89Mods/con-badges/EF-Badge-2024/ImageConverters/README.md

Requires stb_image.c/.h, which can be gotten from here: [https://github.com/nothings/stb](https://github.com/nothings/stb)
