89Mods/con-badges/EF-Badge-2025/HW/HW.kicad_pcb

## KiCad design EF-Badge-2025/HW/HW.kicad_pcb (2025-09-15)

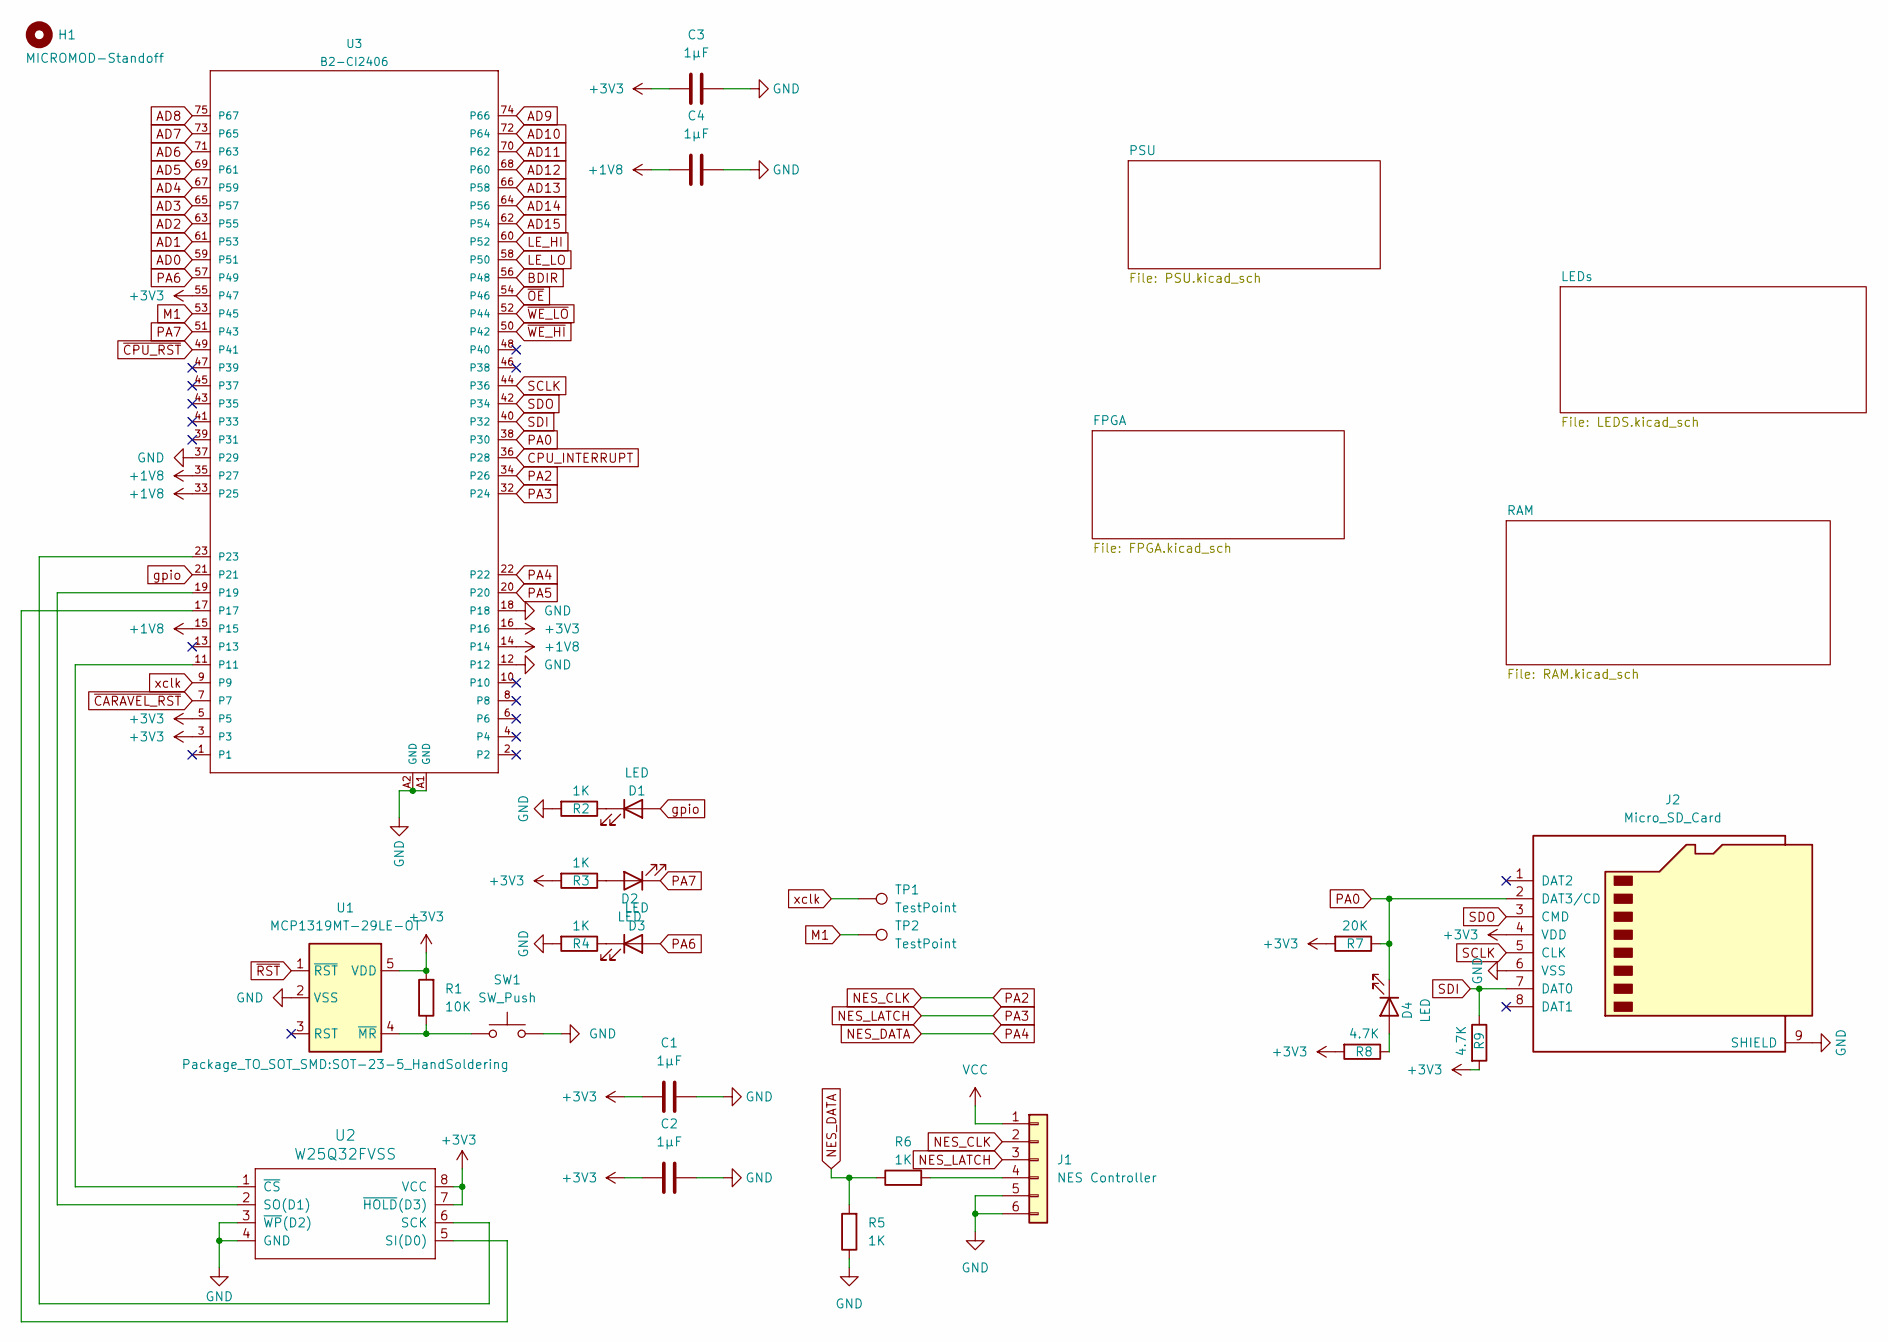
[picture p1: schematic HW.kicad_sch]

Parts:
C1, C2, C3, C4: 1µF; C_0805_2012Metric_Pad1.18x1.45mm_HandSolder
D1, D2, D3, D4: LED; LED_1206_3216Metric_Pad1.42x1.75mm_HandSolder
H1: MICROMOD-Standoff; MicroMod-Standoff
J1: NES Controller; PinSocket_1x06_P2.54mm_Vertical
J2: Micro_SD_Card; microSD_HC_Hirose_DM3AT-SF-PEJM5
R1: 10K; R_1206_3216Metric_Pad1.30x1.75mm_HandSolder
R2, R3, R4, R5, R6: 1K; R_1206_3216Metric_Pad1.30x1.75mm_HandSolder
R7: 20K; R_1206_3216Metric_Pad1.30x1.75mm_HandSolder
R8, R9: 4.7K; R_1206_3216Metric_Pad1.30x1.75mm_HandSolder
SW1: SW_Push; SW_PUSH_6mm
TP1, TP2: TestPoint; TestPoint_Pad_D1.0mm
U1: MCP1319MT-29LE-OT; SOT-23-5_HandSoldering
U2: W25Q32FVSS; DIP-8_W7.62mm; Part # W25Q32JVSSIQ
U3: B2-CI2406; M.2-CONNECTOR-E

Connections:
+1V8: C4.1, U3.14, U3.15, U3.33 (P25), U3.35 (P27); also elsewhere on the board
+3V3: C1.1, C2.1, C3.1, J2.4 (VDD), R1.2, R3.2, R7.2, R8.2, R9.2, U1.5 (VDD), U2.7 (~HOLD(D3)), U2.8 (VCC), U3.3, U3.5, U3.16, U3.55 (P47); also elsewhere on the board
AD0: U3.59 (P51); also elsewhere on the board
AD1: U3.61 (P53); also elsewhere on the board
AD2: U3.63 (P55); also elsewhere on the board
AD3: U3.65 (P57); also elsewhere on the board
AD4: U3.67 (P59); also elsewhere on the board
AD5: U3.69 (P61); also elsewhere on the board
AD6: U3.71 (P63); also elsewhere on the board
AD7: U3.73 (P65); also elsewhere on the board
AD8: U3.75 (P67); also elsewhere on the board
AD9: U3.74 (P66); also elsewhere on the board
AD10: U3.72 (P64); also elsewhere on the board
AD11: U3.70 (P62); also elsewhere on the board
AD12: U3.68 (P60); also elsewhere on the board
AD13: U3.66 (P58); also elsewhere on the board
AD14: U3.64 (P56); also elsewhere on the board
AD15: U3.62 (P54); also elsewhere on the board
BDIR: U3.56 (P48)
CPU_INTERRUPT: U3.36 (P28); also elsewhere on the board
GND: C1.2, C2.2, C3.2, C4.2, J1.5, J1.6, J2.6 (VSS), J2.9 (SHIELD), R2.2, R4.2, R5.1, SW1.2, U1.2 (VSS), U2.3 (~WP(D2)), U2.4 (GND), U3.12, U3.18, U3.37 (P29), U3.A1 (GND), U3.A2 (GND); also elsewhere on the board
LE_HI: U3.60 (P52); also elsewhere on the board
LE_LO: U3.58 (P50); also elsewhere on the board
M1: TP2.1, U3.53 (P45)
NES_CLK: J1.2, U3.34 (P26)
NES_DATA: R5.2, R6.1, U3.22
NES_LATCH: J1.3, U3.32 (P24)
unnamed: D1.1 (K), R2.1
unnamed: D2.2 (A), R3.1
unnamed: D3.1 (K), R4.1
unnamed: D4.2 (A), R8.1
unnamed: J1.4, R6.2
unnamed: R1.1, SW1.1, U1.4 (~MR)
unnamed: U2.6 (SCK), U3.23
unnamed: U2.5 (SI(D0)), U3.17
unnamed: U2.2 (SO(D1)), U3.19
unnamed: U2.1 (~CS), U3.11
PA0: D4.1 (K), J2.2 (DAT3/CD), R7.1, U3.38 (P30)
PA5: U3.20
PA6: D3.2 (A), U3.57 (P49)
PA7: D2.1 (K), U3.51 (P43)
SCLK: J2.5 (CLK), U3.44 (P36)
SDI: J2.7 (DAT0), R9.1, U3.40 (P32)
SDO: J2.3 (CMD), U3.42 (P34)
VCC: J1.1; also elsewhere on the board
gpio: D1.2 (A), U3.21; also elsewhere on the board
xclk: TP1.1, U3.9; also elsewhere on the board
~CARAVEL_RST: U3.7; also elsewhere on the board
~CPU_RST: U3.49 (P41); also elsewhere on the board
~OE: U3.54 (P46); also elsewhere on the board
~RST: U1.1 (~RST); also elsewhere on the board
~WE_HI: U3.50 (P42); also elsewhere on the board
~WE_LO: U3.52 (P44); also elsewhere on the board

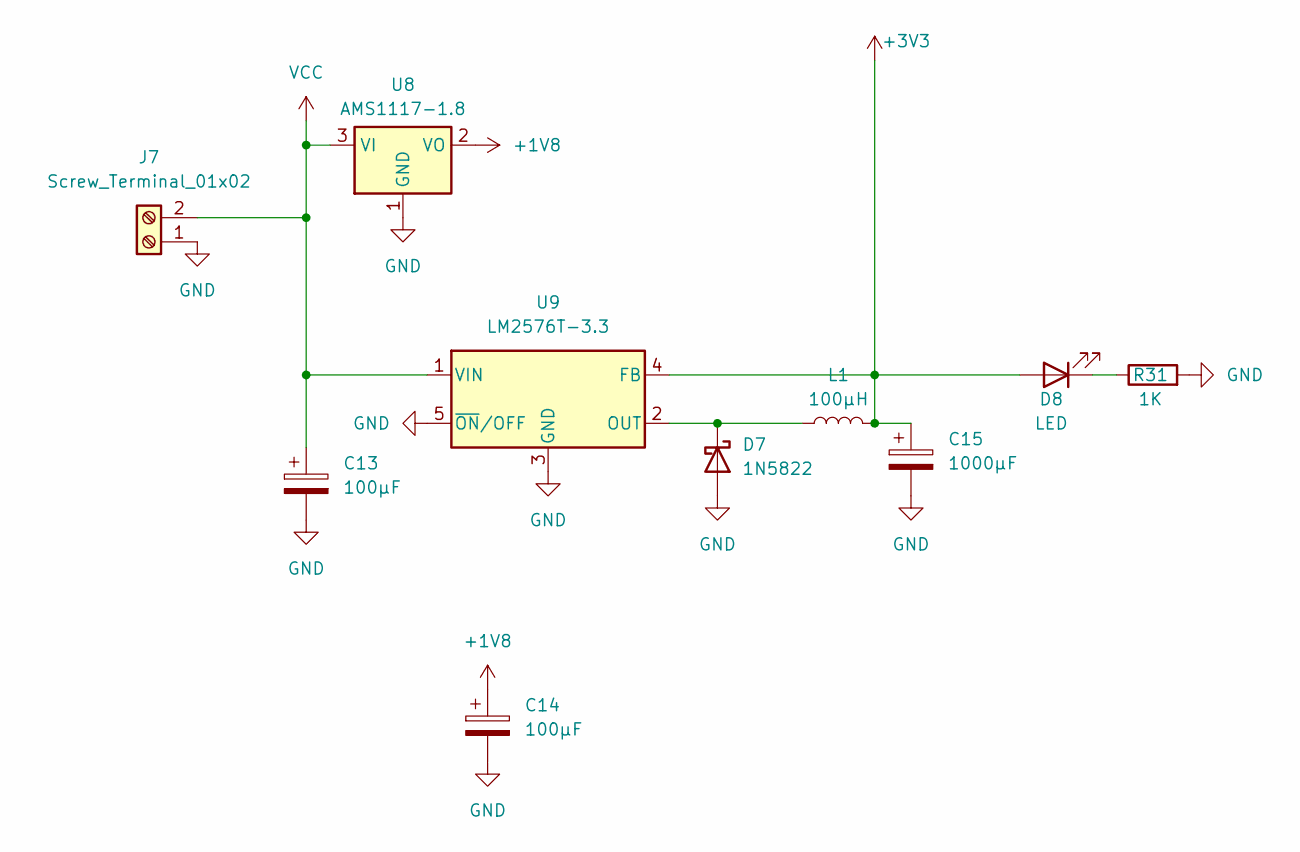
[picture p2: schematic PSU.kicad_sch]

Parts:
C13: 100µF; CP_Radial_D5.0mm_P2.50mm
C14: 100µF; CP_Elec_4x3
C15: 1000µF; CP_Radial_D6.3mm_P2.50mm
D7: 1N5822; D_DO-201AD_P15.24mm_Horizontal
D8: LED; LED_1206_3216Metric_Pad1.42x1.75mm_HandSolder
J7: Screw_Terminal_01x02; TerminalBlock_bornier-2_P5.08mm
L1: 100µH; L_Radial_D6.0mm_P4.00mm
R31: 1K; R_1206_3216Metric_Pad1.30x1.75mm_HandSolder
U8: AMS1117-1.8; SOT-223-3_TabPin2
U9: LM2576T-3.3; TO-220-5_Horizontal_TabDown_Fixed

Connections:
+1V8: C14.1, U8.2 (VO); also elsewhere on the board
+3V3: C15.1, D8.2 (A), L1.2, U9.4 (FB); also elsewhere on the board
GND: C13.2, C14.2, C15.2, D7.2 (A), J7.1, R31.2, U8.1 (GND), U9.3 (GND), U9.5 (~ON/OFF); also elsewhere on the board
unnamed: D7.1 (K), L1.1, U9.2 (OUT)
unnamed: D8.1 (K), R31.1
VCC: C13.1, J7.2, U8.3 (VI), U9.1 (VIN); also elsewhere on the board

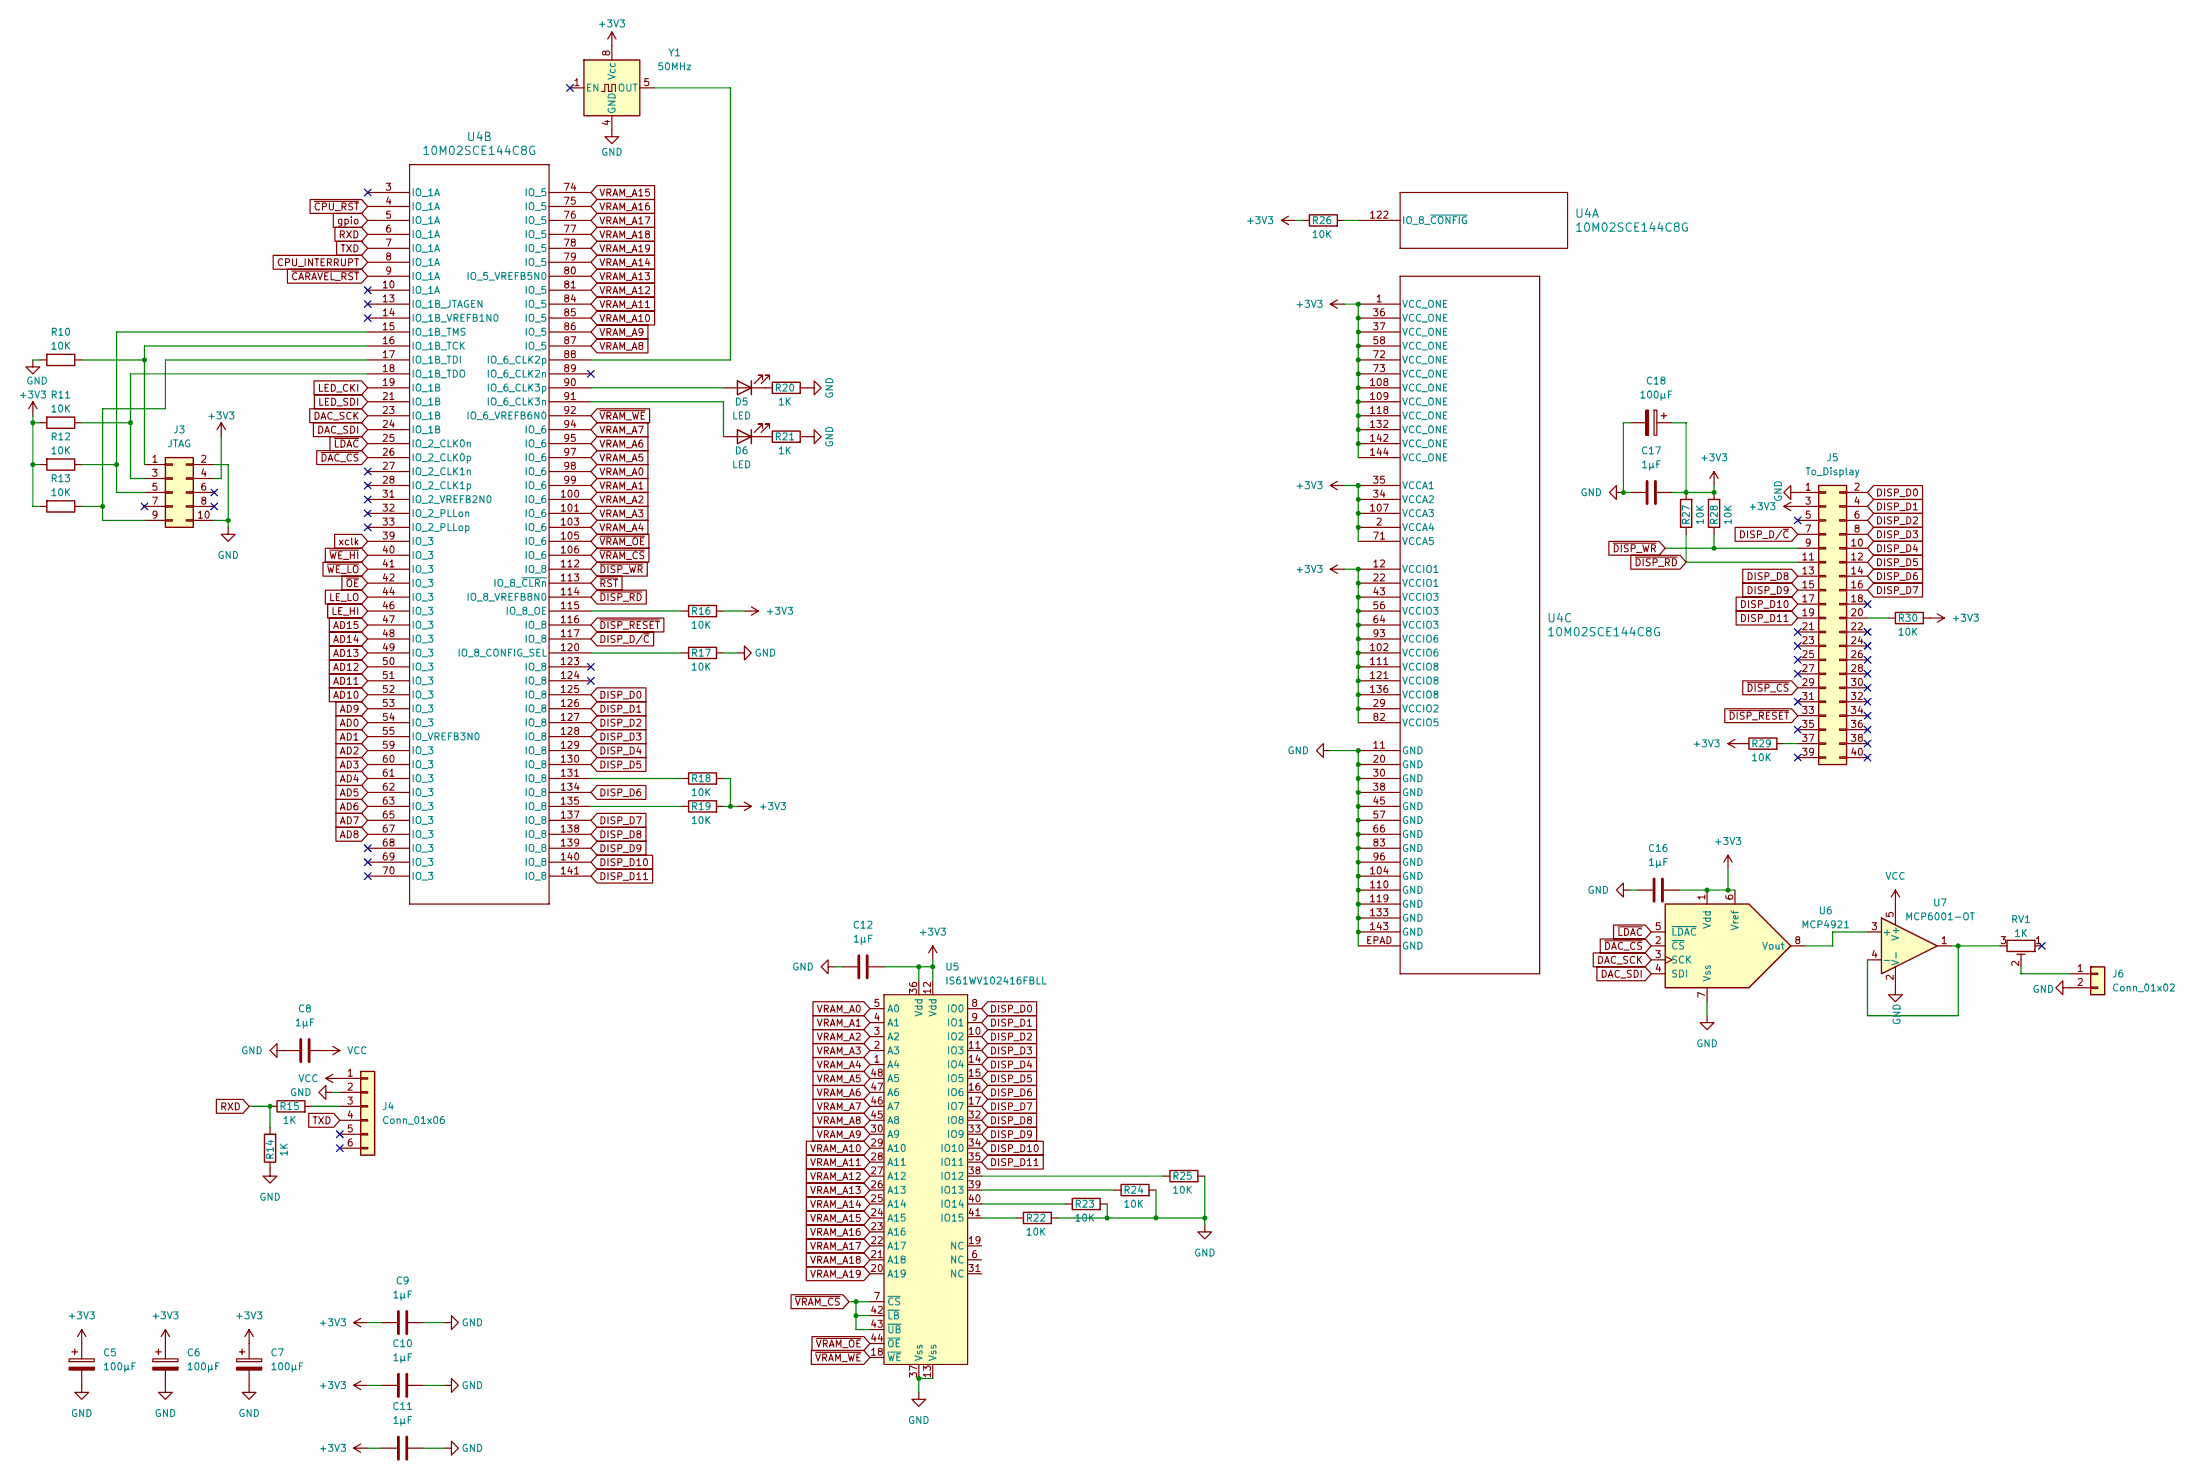
[picture p3: schematic FPGA.kicad_sch]

Parts:
C5, C6, C7, C18: 100µF; CP_Elec_4x3
C8, C9, C10, C11, C12, C16, C17: 1µF; C_0805_2012Metric_Pad1.18x1.45mm_HandSolder
D5, D6: LED; LED_1206_3216Metric_Pad1.42x1.75mm_HandSolder
J3: JTAG; PinHeader_2x05_P2.54mm_Vertical
J4: Conn_01x06; PinSocket_1x06_P2.54mm_Vertical
J5: To_Display; PinHeader_2x20_P2.54mm_Vertical
J6: Conn_01x02; PinHeader_1x02_P2.54mm_Vertical
R10, R11, R12, R13, R16, R17, R18, R19, R22, R23, R24, R25, R26, R27, R28, R29, R30: 10K; R_1206_3216Metric_Pad1.30x1.75mm_HandSolder
R14, R15, R20, R21: 1K; R_1206_3216Metric_Pad1.30x1.75mm_HandSolder
RV1: 1K; Potentiometer_ACP_CA9-V10_Vertical
U4: 10M02SCE144C8G; EQFP144_A-1.65-D2-4.0_INT
U5: IS61WV102416FBLL; TSOP-I-48_18.4x12mm_P0.5mm; Mouser 870-61WV12416FBL1TLI
U6: MCP4921; DIP-8_W7.62mm
U7: MCP6001-OT; SOT-23-5
Y1: 50MHz; Oscillator_DIP-8

Connections:
+3V3: C5.1, C6.1, C7.1, C9.1, C10.1, C11.1, C12.2, C16.2, C17.2, C18.1, J3.4, J5.3, R11.2, R12.2, R13.2, R16.2, R18.2, R19.2, R26.1, R27.2, R28.2, R29.1, R30.2, U4.1 (VCC_ONE), U4.2 (VCCA4), U4.12 (VCCIO1), U4.22 (VCCIO1), U4.29 (VCCIO2), U4.34 (VCCA2), U4.35 (VCCA1), U4.36 (VCC_ONE), U4.37 (VCC_ONE), U4.43 (VCCIO3), U4.56 (VCCIO3), U4.58 (VCC_ONE), U4.64 (VCCIO3), U4.71 (VCCA5), U4.72 (VCC_ONE), U4.73 (VCC_ONE), U4.82 (VCCIO5), U4.93 (VCCIO6), U4.102 (VCCIO6), U4.107 (VCCA3), U4.108 (VCC_ONE), U4.109 (VCC_ONE), U4.111 (VCCIO8), U4.118 (VCC_ONE), U4.121 (VCCIO8), U4.132 (VCC_ONE), U4.136 (VCCIO8), U4.142 (VCC_ONE), U4.144 (VCC_ONE), U5.12 (Vdd), U5.36 (Vdd), U6.1 (Vdd), U6.6 (Vref), Y1.8 (Vcc); also elsewhere on the board
AD0: U4.54 (IO_3); also elsewhere on the board
AD1: U4.55 (IO_VREFB3N0); also elsewhere on the board
AD2: U4.59 (IO_3); also elsewhere on the board
AD3: U4.60 (IO_3); also elsewhere on the board
AD4: U4.61 (IO_3); also elsewhere on the board
AD5: U4.62 (IO_3); also elsewhere on the board
AD6: U4.63 (IO_3); also elsewhere on the board
AD7: U4.65 (IO_3); also elsewhere on the board
AD8: U4.67 (IO_3); also elsewhere on the board
AD9: U4.53 (IO_3); also elsewhere on the board
AD10: U4.52 (IO_3); also elsewhere on the board
AD11: U4.51 (IO_3); also elsewhere on the board
AD12: U4.50 (IO_3); also elsewhere on the board
AD13: U4.49 (IO_3); also elsewhere on the board
AD14: U4.48 (IO_3); also elsewhere on the board
AD15: U4.47 (IO_3); also elsewhere on the board
CPU_INTERRUPT: U4.8 (IO_1A); also elsewhere on the board
DAC_SCK: U4.23 (IO_1B), U6.3 (SCK)
DAC_SDI: U4.24 (IO_1B), U6.4 (SDI)
DISP_D0: J5.2, U4.125 (IO_8), U5.8 (IO0)
DISP_D1: J5.4, U4.126 (IO_8), U5.9 (IO1)
DISP_D2: J5.6, U4.127 (IO_8), U5.10 (IO2)
DISP_D3: J5.8, U4.128 (IO_8), U5.11 (IO3)
DISP_D4: J5.10, U4.129 (IO_8), U5.14 (IO4)
DISP_D5: J5.12, U4.130 (IO_8), U5.15 (IO5)
DISP_D6: J5.14, U4.134 (IO_8), U5.16 (IO6)
DISP_D7: J5.16, U4.137 (IO_8), U5.17 (IO7)
DISP_D8: J5.13, U4.138 (IO_8), U5.32 (IO8)
DISP_D9: J5.15, U4.139 (IO_8), U5.33 (IO9)
DISP_D10: J5.17, U4.140 (IO_8), U5.34 (IO10)
DISP_D11: J5.19, U4.141 (IO_8), U5.35 (IO11)
DISP_D/~C: J5.7, U4.117 (IO_8)
GND: C5.2, C6.2, C7.2, C8.1, C9.2, C10.2, C11.2, C12.1, C16.1, C17.1, C18.2, J3.2, J3.10, J4.2, J5.1, J6.2, R10.2, R14.1, R17.2, R20.2, R21.2, R22.2, R23.2, R24.2, R25.2, U4.11 (GND), U4.20 (GND), U4.30 (GND), U4.38 (GND), U4.45 (GND), U4.57 (GND), U4.66 (GND), U4.83 (GND), U4.96 (GND), U4.104 (GND), U4.110 (GND), U4.119 (GND), U4.133 (GND), U4.143 (GND), U4.EPAD (GND), U5.13 (Vss), U5.37 (Vss), U6.7 (Vss), U7.2 (V-), Y1.4 (GND); also elsewhere on the board
LED_CKI: U4.19 (IO_1B); also elsewhere on the board
LED_SDI: U4.21 (IO_1B); also elsewhere on the board
LE_HI: U4.46 (IO_3); also elsewhere on the board
LE_LO: U4.44 (IO_3); also elsewhere on the board
unnamed: D5.2 (A), U4.90 (IO_6_CLK3p)
unnamed: D5.1 (K), R20.1
unnamed: D6.2 (A), U4.91 (IO_6_CLK3n)
unnamed: D6.1 (K), R21.1
unnamed: J3.1, R10.1, U4.16 (IO_1B_TCK)
unnamed: J3.3, R11.1, U4.18 (IO_1B_TDO)
unnamed: J3.5, R12.1, U4.15 (IO_1B_TMS)
unnamed: J3.9, R13.1, U4.17 (IO_1B_TDI)
unnamed: J4.3, R15.2
unnamed: J5.20, R30.1
unnamed: J5.37, R29.2
unnamed: J6.1, RV1.2
unnamed: R18.1, U4.131 (IO_8)
unnamed: R19.1, U4.135 (IO_8)
unnamed: R26.2, U4.122 (IO_8_~CONFIG)
unnamed: U4.88 (IO_6_CLK2p), Y1.5 (OUT)
unnamed: R17.1, U4.120 (IO_8_CONFIG_SEL)
unnamed: R16.1, U4.115 (IO_8_OE)
unnamed: R25.1, U5.38 (IO12)
unnamed: R24.1, U5.39 (IO13)
unnamed: R23.1, U5.40 (IO14)
unnamed: R22.1, U5.41 (IO15)
unnamed: U6.8 (Vout), U7.3 (+)
unnamed: RV1.3, U7.1, U7.4 (-)
RXD: R14.2, R15.1, U4.6 (IO_1A)
TXD: J4.4, U4.7 (IO_1A)
VCC: C8.2, J4.1, U7.5 (V+); also elsewhere on the board
VRAM_A0: U4.98 (IO_6), U5.5 (A0)
VRAM_A1: U4.99 (IO_6), U5.4 (A1)
VRAM_A2: U4.100 (IO_6), U5.3 (A2)
VRAM_A3: U4.101 (IO_6), U5.2 (A3)
VRAM_A4: U4.103 (IO_6), U5.1 (A4)
VRAM_A5: U4.97 (IO_6), U5.48 (A5)
VRAM_A6: U4.95 (IO_6), U5.47 (A6)
VRAM_A7: U4.94 (IO_6), U5.46 (A7)
VRAM_A8: U4.87 (IO_5), U5.45 (A8)
VRAM_A9: U4.86 (IO_5), U5.30 (A9)
VRAM_A10: U4.85 (IO_5), U5.29 (A10)
VRAM_A11: U4.84 (IO_5), U5.28 (A11)
VRAM_A12: U4.81 (IO_5), U5.27 (A12)
VRAM_A13: U4.80 (IO_5_VREFB5N0), U5.26 (A13)
VRAM_A14: U4.79 (IO_5), U5.25 (A14)
VRAM_A15: U4.74 (IO_5), U5.24 (A15)
VRAM_A16: U4.75 (IO_5), U5.23 (A16)
VRAM_A17: U4.76 (IO_5), U5.22 (A17)
VRAM_A18: U4.77 (IO_5), U5.21 (A18)
VRAM_A19: U4.78 (IO_5), U5.20 (A19)
gpio: U4.5 (IO_1A); also elsewhere on the board
xclk: U4.39 (IO_3); also elsewhere on the board
~CARAVEL_RST: U4.9 (IO_1A); also elsewhere on the board
~CPU_RST: U4.4 (IO_1A); also elsewhere on the board
~DAC_CS: U4.26 (IO_2_CLK0p), U6.2 (~CS)
~DISP_CS: J5.29
~DISP_RD: J5.11, R27.1, U4.114 (IO_8_VREFB8N0)
~DISP_RESET: J5.33, U4.116 (IO_8)
~DISP_WR: J5.9, R28.1, U4.112 (IO_8)
~LDAC: U4.25 (IO_2_CLK0n), U6.5 (~LDAC)
~OE: U4.42 (IO_3); also elsewhere on the board
~RST: U4.113 (IO_8_~CLRn); also elsewhere on the board
~VRAM_CS: U4.106 (IO_6), U5.7 (~CS), U5.42 (~LB), U5.43 (~UB)
~VRAM_OE: U4.105 (IO_6), U5.44 (~OE)
~VRAM_WE: U4.92 (IO_6_VREFB6N0), U5.18 (~WE)
~WE_HI: U4.40 (IO_3); also elsewhere on the board
~WE_LO: U4.41 (IO_3); also elsewhere on the board

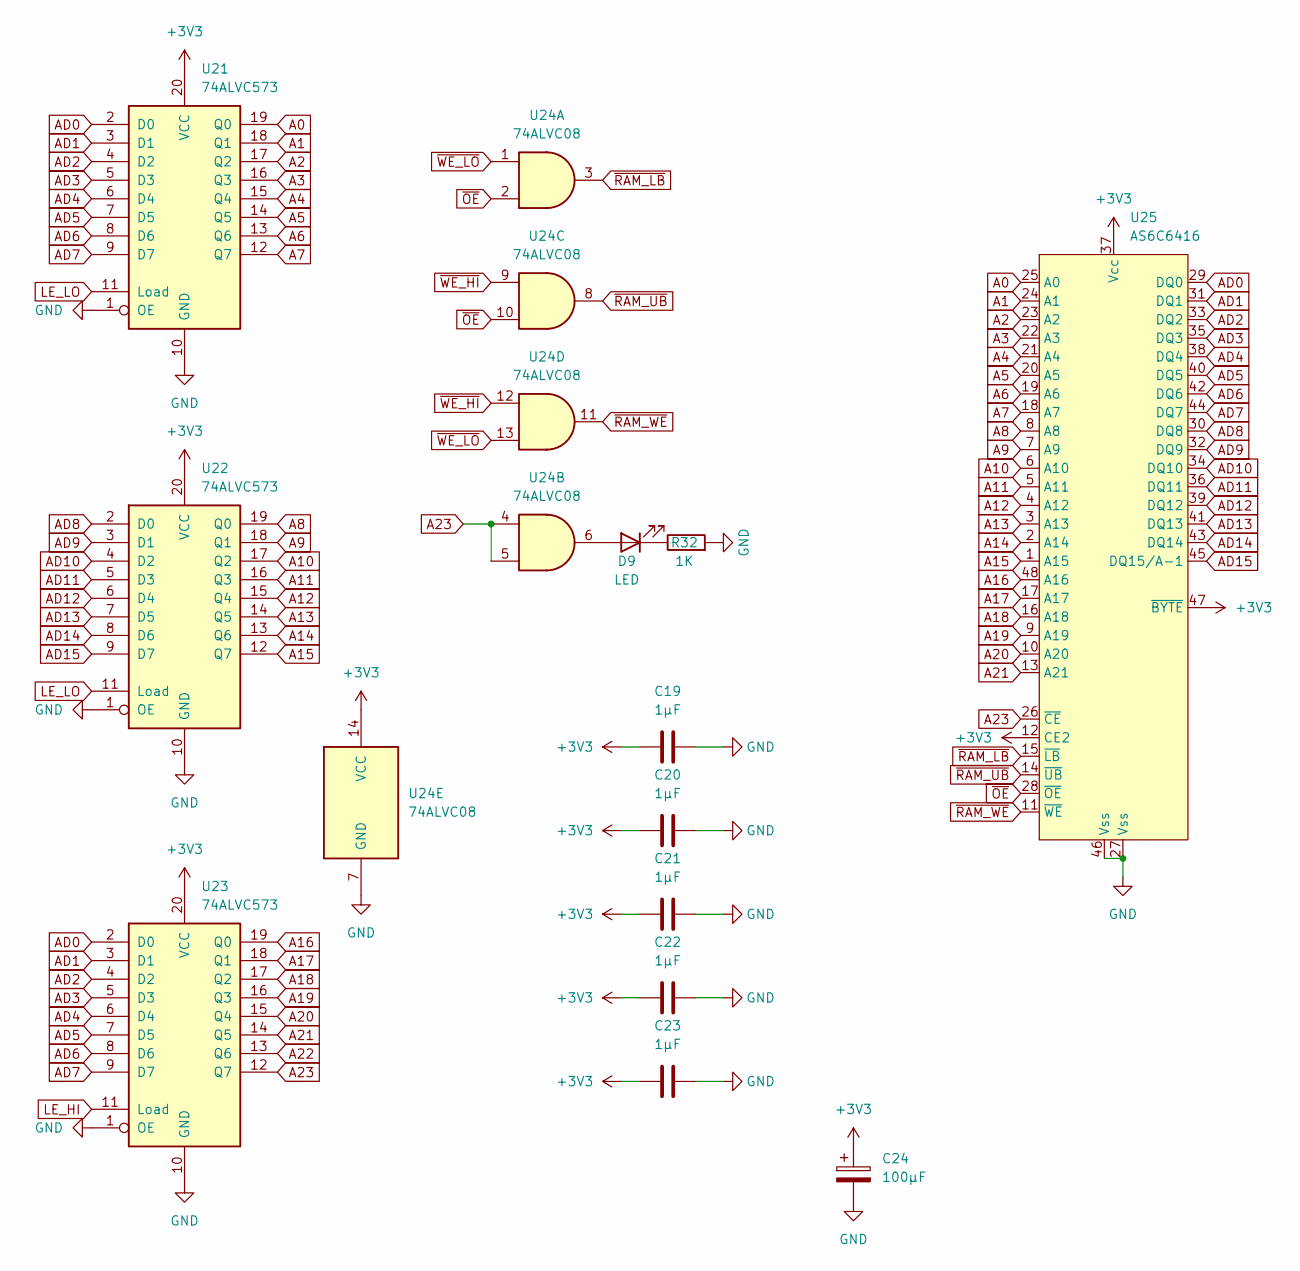
[picture p4: schematic RAM.kicad_sch]

Parts:
C19, C20, C21, C22, C23: 1µF; C_0805_2012Metric_Pad1.18x1.45mm_HandSolder
C24: 100µF; CP_Elec_4x3
D9: LED; LED_1206_3216Metric_Pad1.42x1.75mm_HandSolder
R32: 1K; R_1206_3216Metric_Pad1.30x1.75mm_HandSolder
U21, U22, U23: 74ALVC573; TSSOP-20_4.4x6.5mm_P0.65mm; Mouser 771-ALVC573PW118
U24: 74ALVC08; SOIC-14_3.9x8.7mm_P1.27mm; Mouser 771-ALVC08D118
U25: AS6C6416; TSOP-I-48_18.4x12mm_P0.5mm; Mouser 913-AS6C6416-55TIN

Connections:
+3V3: C19.1, C20.1, C21.1, C22.1, C23.1, C24.1, U21.20 (VCC), U22.20 (VCC), U23.20 (VCC), U24.14 (VCC), U25.12 (CE2), U25.37 (Vcc), U25.47 (~BYTE); also elsewhere on the board
A0: U21.19 (Q0), U25.25 (A0)
A1: U21.18 (Q1), U25.24 (A1)
A2: U21.17 (Q2), U25.23 (A2)
A3: U21.16 (Q3), U25.22 (A3)
A4: U21.15 (Q4), U25.21 (A4)
A5: U21.14 (Q5), U25.20 (A5)
A6: U21.13 (Q6), U25.19 (A6)
A7: U21.12 (Q7), U25.18 (A7)
A8: U22.19 (Q0), U25.8 (A8)
A9: U22.18 (Q1), U25.7 (A9)
A10: U22.17 (Q2), U25.6 (A10)
A11: U22.16 (Q3), U25.5 (A11)
A12: U22.15 (Q4), U25.4 (A12)
A13: U22.14 (Q5), U25.3 (A13)
A14: U22.13 (Q6), U25.2 (A14)
A15: U22.12 (Q7), U25.1 (A15)
A16: U23.19 (Q0), U25.48 (A16)
A17: U23.18 (Q1), U25.17 (A17)
A18: U23.17 (Q2), U25.16 (A18)
A19: U23.16 (Q3), U25.9 (A19)
A20: U23.15 (Q4), U25.10 (A20)
A21: U23.14 (Q5), U25.13 (A21)
A22: U23.13 (Q6)
A23: U23.12 (Q7), U24.4, U24.5, U25.26 (~CE)
AD0: U21.2 (D0), U23.2 (D0), U25.29 (DQ0); also elsewhere on the board
AD1: U21.3 (D1), U23.3 (D1), U25.31 (DQ1); also elsewhere on the board
AD2: U21.4 (D2), U23.4 (D2), U25.33 (DQ2); also elsewhere on the board
AD3: U21.5 (D3), U23.5 (D3), U25.35 (DQ3); also elsewhere on the board
AD4: U21.6 (D4), U23.6 (D4), U25.38 (DQ4); also elsewhere on the board
AD5: U21.7 (D5), U23.7 (D5), U25.40 (DQ5); also elsewhere on the board
AD6: U21.8 (D6), U23.8 (D6), U25.42 (DQ6); also elsewhere on the board
AD7: U21.9 (D7), U23.9 (D7), U25.44 (DQ7); also elsewhere on the board
AD8: U22.2 (D0), U25.30 (DQ8); also elsewhere on the board
AD9: U22.3 (D1), U25.32 (DQ9); also elsewhere on the board
AD10: U22.4 (D2), U25.34 (DQ10); also elsewhere on the board
AD11: U22.5 (D3), U25.36 (DQ11); also elsewhere on the board
AD12: U22.6 (D4), U25.39 (DQ12); also elsewhere on the board
AD13: U22.7 (D5), U25.41 (DQ13); also elsewhere on the board
AD14: U22.8 (D6), U25.43 (DQ14); also elsewhere on the board
AD15: U22.9 (D7), U25.45 (DQ15/A-1); also elsewhere on the board
GND: C19.2, C20.2, C21.2, C22.2, C23.2, C24.2, R32.2, U21.1 (OE), U21.10 (GND), U22.1 (OE), U22.10 (GND), U23.1 (OE), U23.10 (GND), U24.7 (GND), U25.27 (Vss), U25.46 (Vss); also elsewhere on the board
LE_HI: U23.11 (Load); also elsewhere on the board
LE_LO: U21.11 (Load), U22.11 (Load); also elsewhere on the board
unnamed: D9.2 (A), U24.6
unnamed: D9.1 (K), R32.1
~OE: U24.2, U24.10, U25.28 (~OE); also elsewhere on the board
~RAM_LB: U24.3, U25.15 (~LB)
~RAM_UB: U24.8, U25.14 (~UB)
~RAM_WE: U24.11, U25.11 (~WE)
~WE_HI: U24.9, U24.12; also elsewhere on the board
~WE_LO: U24.1, U24.13; also elsewhere on the board

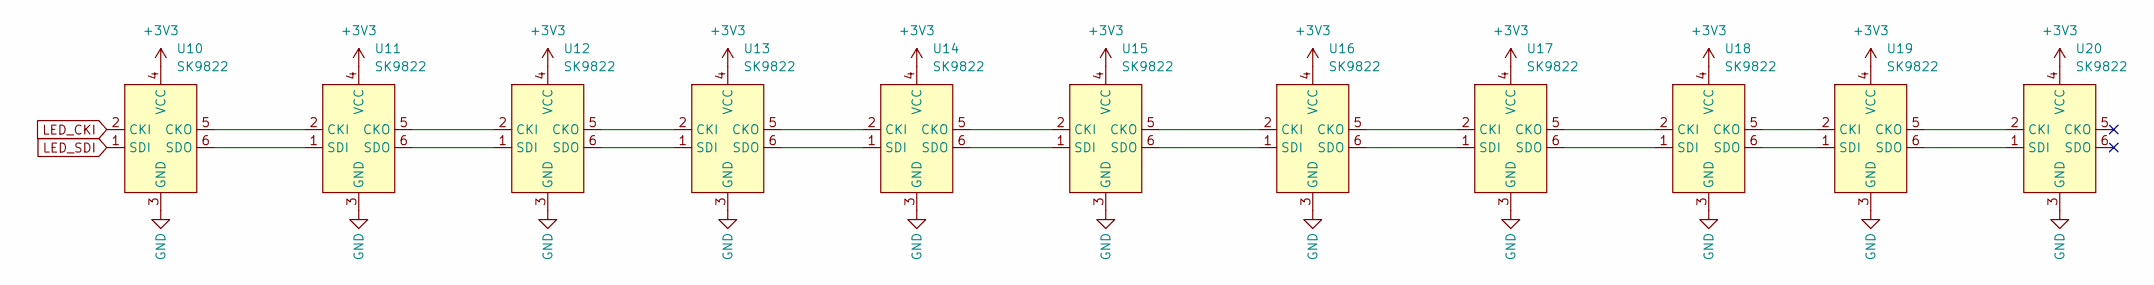
[picture p5: schematic LEDS.kicad_sch]

Parts:
U10, U11, U12, U13, U14, U15, U16, U17, U18, U19, U20: SK9822; SK9822-EC20

Connections:
+3V3: U10.4 (VCC), U11.4 (VCC), U12.4 (VCC), U13.4 (VCC), U14.4 (VCC), U15.4 (VCC), U16.4 (VCC), U17.4 (VCC), U18.4 (VCC), U19.4 (VCC), U20.4 (VCC); also elsewhere on the board
GND: U10.3 (GND), U11.3 (GND), U12.3 (GND), U13.3 (GND), U14.3 (GND), U15.3 (GND), U16.3 (GND), U17.3 (GND), U18.3 (GND), U19.3 (GND), U20.3 (GND); also elsewhere on the board
LED_CKI: U10.2 (CKI); also elsewhere on the board
LED_SDI: U10.1 (SDI); also elsewhere on the board
unnamed: U10.5 (CKO), U11.2 (CKI)
unnamed: U10.6 (SDO), U11.1 (SDI)
unnamed: U11.5 (CKO), U12.2 (CKI)
unnamed: U11.6 (SDO), U12.1 (SDI)
unnamed: U12.5 (CKO), U13.2 (CKI)
unnamed: U12.6 (SDO), U13.1 (SDI)
unnamed: U13.5 (CKO), U14.2 (CKI)
unnamed: U13.6 (SDO), U14.1 (SDI)
unnamed: U14.5 (CKO), U15.2 (CKI)
unnamed: U14.6 (SDO), U15.1 (SDI)
unnamed: U15.5 (CKO), U16.2 (CKI)
unnamed: U15.6 (SDO), U16.1 (SDI)
unnamed: U16.5 (CKO), U17.2 (CKI)
unnamed: U16.6 (SDO), U17.1 (SDI)
unnamed: U17.5 (CKO), U18.2 (CKI)
unnamed: U17.6 (SDO), U18.1 (SDI)
unnamed: U18.5 (CKO), U19.2 (CKI)
unnamed: U18.6 (SDO), U19.1 (SDI)
unnamed: U19.5 (CKO), U20.2 (CKI)
unnamed: U19.6 (SDO), U20.1 (SDI)

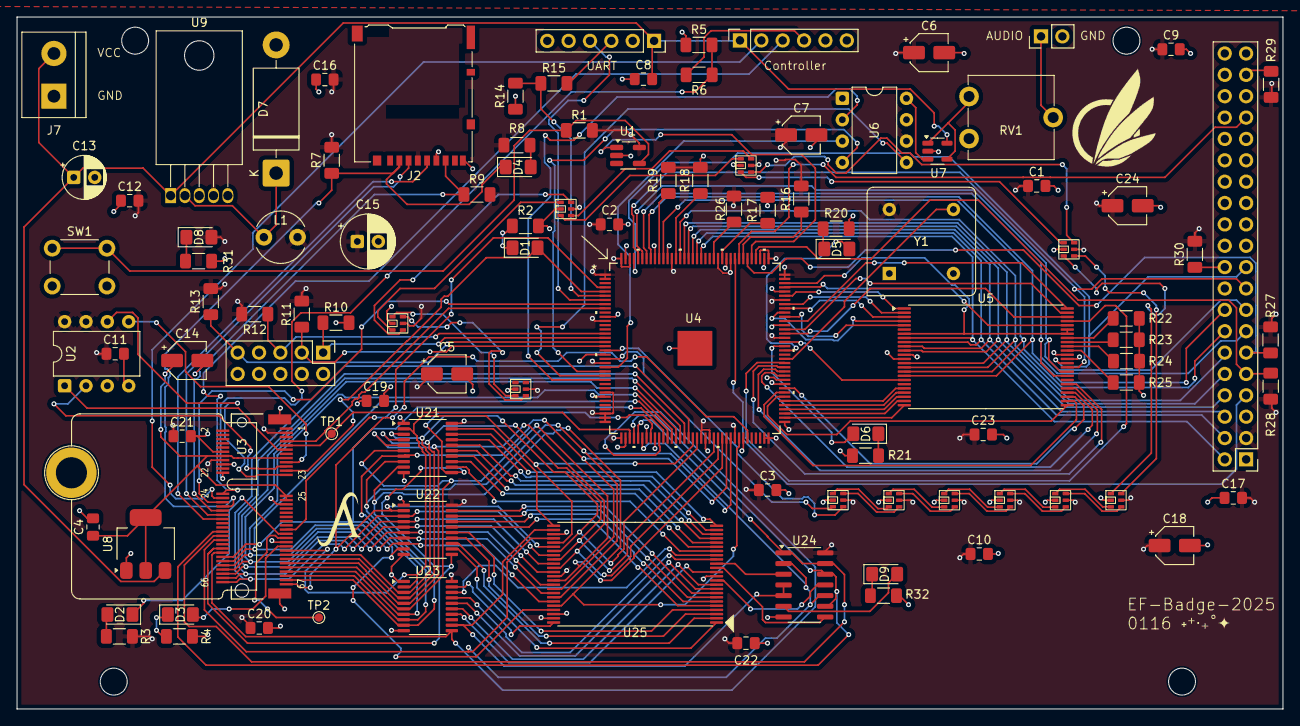
[picture p6: board HW.kicad_pcb from above]

Board: 4 copper layers, 150.5 x 82.3 mm, 104 parts (0 on the bottom side), 172 nets.
