89Mods/con-badges/EF-Badge-2024/HW/badge-rom-programmer/badge-rom-programmer.kicad_pcb

## KiCad design EF-Badge-2024/HW/badge-rom-programmer/badge-rom-programmer.kicad_pcb (2024-09-29)

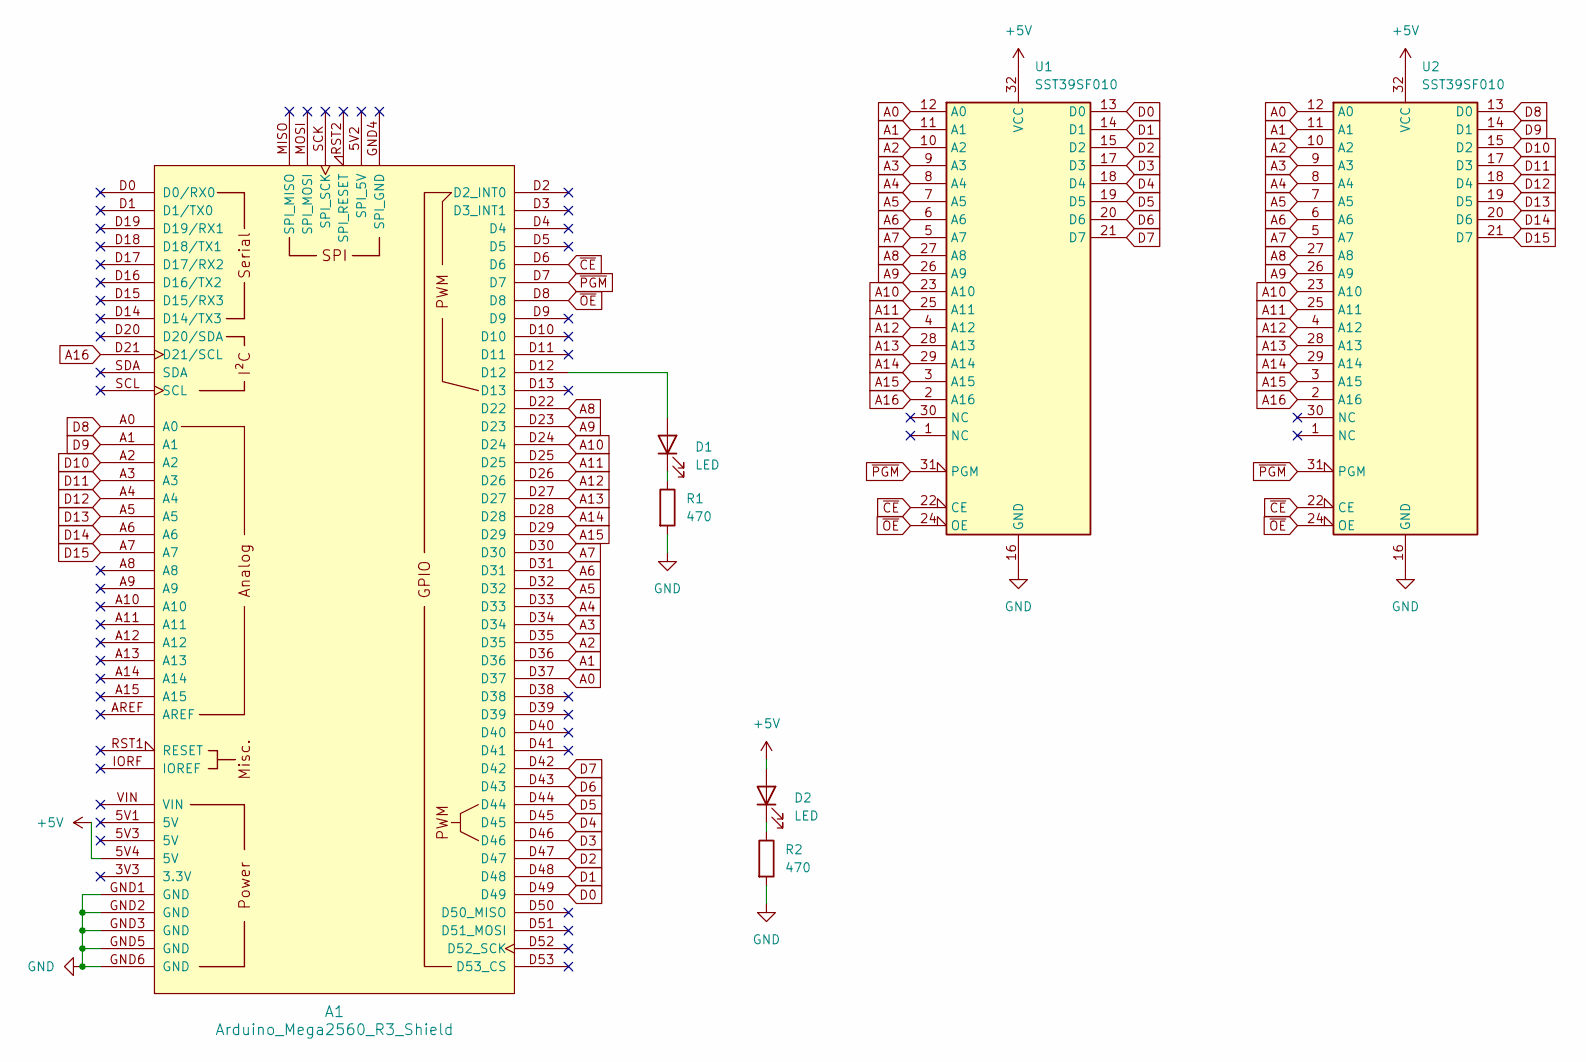
[picture p7: schematic badge-rom-programmer.kicad_sch]

Parts:
A1: Arduino_Mega2560_R3_Shield
D1, D2: LED; LED_D3.0mm
R1, R2: 470; R_Axial_DIN0204_L3.6mm_D1.6mm_P7.62mm_Horizontal
U1, U2: SST39SF010; PLCC-32_THT-Socket

Connections:
+5V: A1.5V4 (5V), D2.2 (A), U1.32 (VCC), U2.32 (VCC)
A0: A1.D37, U1.12 (A0), U2.12 (A0)
A1: A1.D36, U1.11 (A1), U2.11 (A1)
A2: A1.D35, U1.10 (A2), U2.10 (A2)
A3: A1.D34, U1.9 (A3), U2.9 (A3)
A4: A1.D33, U1.8 (A4), U2.8 (A4)
A5: A1.D32, U1.7 (A5), U2.7 (A5)
A6: A1.D31, U1.6 (A6), U2.6 (A6)
A7: A1.D30, U1.5 (A7), U2.5 (A7)
A8: A1.D22, U1.27 (A8), U2.27 (A8)
A9: A1.D23, U1.26 (A9), U2.26 (A9)
A10: A1.D24, U1.23 (A10), U2.23 (A10)
A11: A1.D25, U1.25 (A11), U2.25 (A11)
A12: A1.D26, U1.4 (A12), U2.4 (A12)
A13: A1.D27, U1.28 (A13), U2.28 (A13)
A14: A1.D28, U1.29 (A14), U2.29 (A14)
A15: A1.D29, U1.3 (A15), U2.3 (A15)
A16: A1.D21 (D21/SCL), U1.2 (A16), U2.2 (A16)
D0: A1.D49, U1.13 (D0)
D1: A1.D48, U1.14 (D1)
D2: A1.D47, U1.15 (D2)
D3: A1.D46, U1.17 (D3)
D4: A1.D45, U1.18 (D4)
D5: A1.D44, U1.19 (D5)
D6: A1.D43, U1.20 (D6)
D7: A1.D42, U1.21 (D7)
D8: A1.A0, U2.13 (D0)
D9: A1.A1, U2.14 (D1)
D10: A1.A2, U2.15 (D2)
D11: A1.A3, U2.17 (D3)
D12: A1.A4, U2.18 (D4)
D13: A1.A5, U2.19 (D5)
D14: A1.A6, U2.20 (D6)
D15: A1.A7, U2.21 (D7)
GND: A1.GND1 (GND), A1.GND2 (GND), A1.GND3 (GND), A1.GND5 (GND), A1.GND6 (GND), R1.2, R2.2, U1.16 (GND), U2.16 (GND)
unnamed: A1.D12, D1.2 (A)
unnamed: D1.1 (K), R1.1
unnamed: D2.1 (K), R2.1
~CE: A1.D6, U1.22 (CE), U2.22 (CE)
~OE: A1.D8, U1.24 (OE), U2.24 (OE)
~PGM: A1.D7, U1.31 (PGM), U2.31 (PGM)

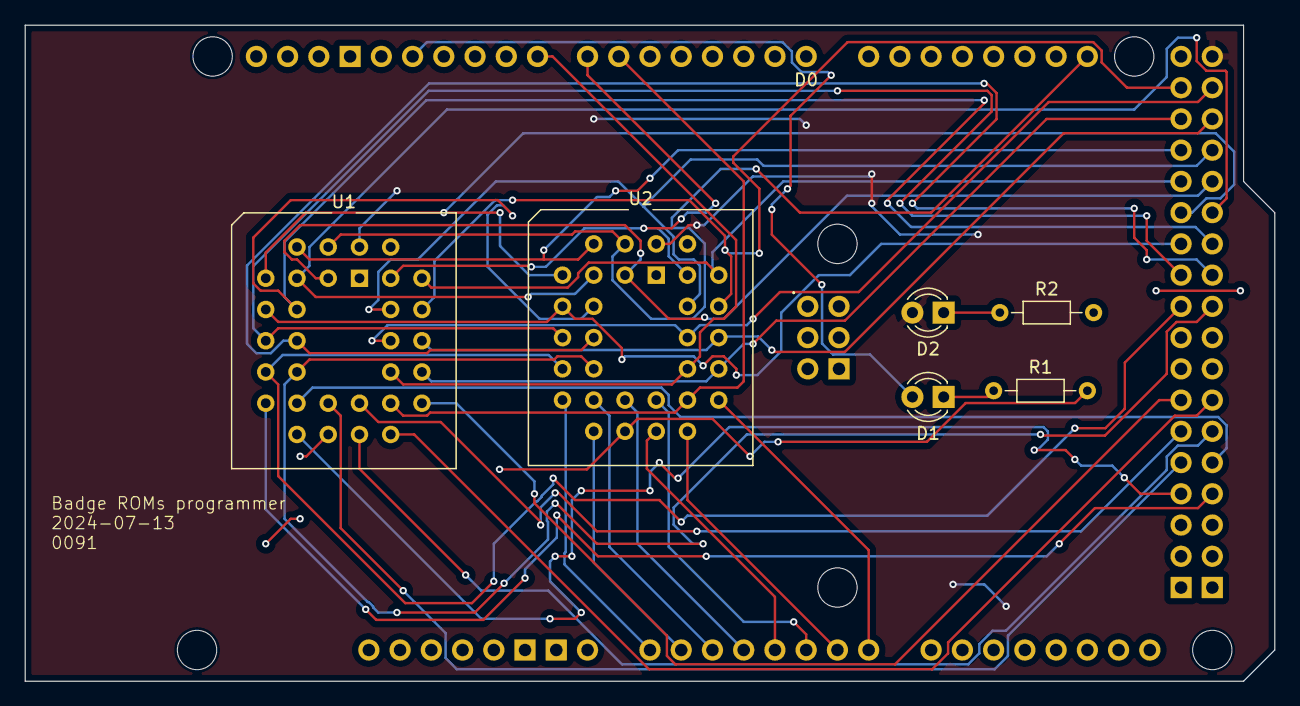
[picture p8: board badge-rom-programmer.kicad_pcb from above]

Board: 2 copper layers, 101.6 x 53.3 mm, 7 parts (0 on the bottom side), 41 nets.
