89Mods/con-badges/EF-Badge-2024/HW/EF-Badge-2024/EF-Badge-2024.kicad_pcb

## KiCad design EF-Badge-2024/HW/EF-Badge-2024/EF-Badge-2024.kicad_pcb (2024-09-29)

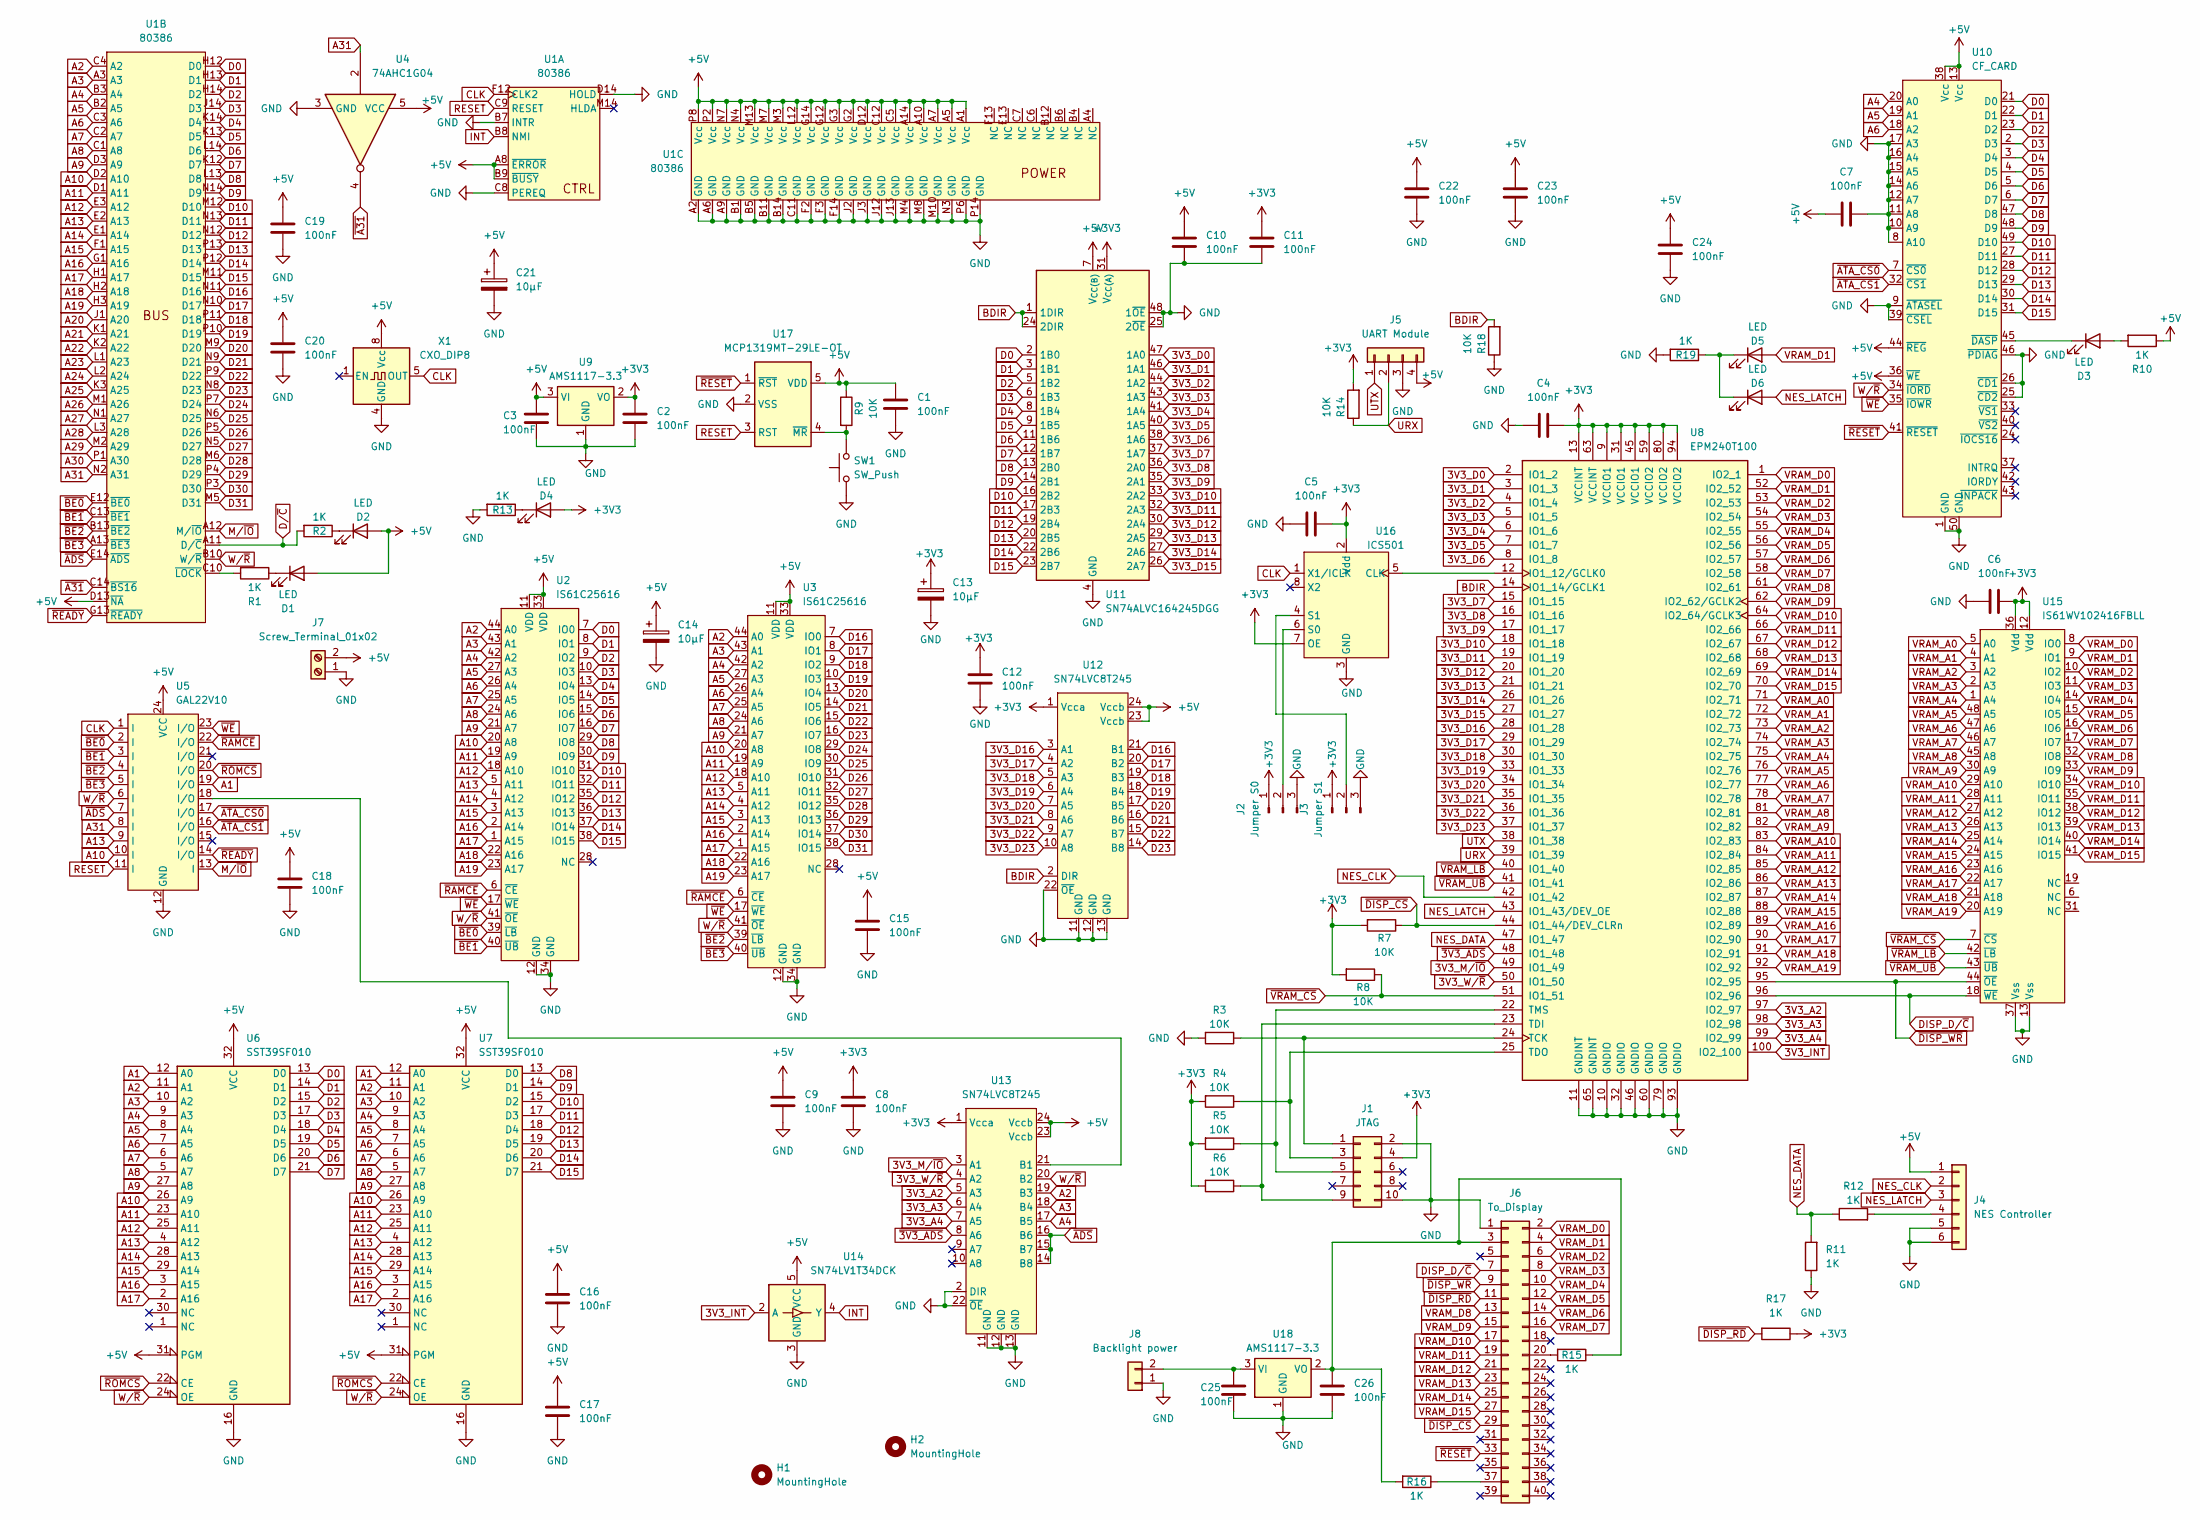
[picture p9: schematic EF-Badge-2024.kicad_sch]

Parts:
C1, C2, C3, C4, C5, C6, C7, C8, C9, C10, C11, C12, C15, C16, C17, C18, C19, C20, C22, C23, C24, C25, C26: 100nF; C_0805_2012Metric_Pad1.18x1.45mm_HandSolder
C13, C14, C21: 10µF; CP_Elec_3x5.4
D1, D2, D3, D4, D5, D6: LED; LED_1206_3216Metric_Pad1.42x1.75mm_HandSolder
H1, H2: MountingHole; MountingHole_3.2mm_M3_ISO7380
J1: JTAG; PinHeader_2x05_P2.54mm_Vertical
J2: Jumper S0; PinHeader_1x03_P2.54mm_Vertical
J3: Jumper S1; PinHeader_1x03_P2.54mm_Vertical
J4: NES Controller; PinSocket_1x06_P2.54mm_Vertical
J5: UART Module; PinHeader_1x04_P2.54mm_Vertical
J6: To_Display; PinHeader_2x20_P2.54mm_Vertical
J7: Screw_Terminal_01x02; TerminalBlock_bornier-2_P5.08mm
J8: Backlight power; PinHeader_1x02_P2.54mm_Vertical
R1, R2, R10, R11, R12, R13, R15, R16, R17, R19: 1K; R_1206_3216Metric_Pad1.30x1.75mm_HandSolder
R3, R4, R5, R6, R7, R8, R9, R14, R18: 10K; R_1206_3216Metric_Pad1.30x1.75mm_HandSolder
SW1: SW_Push; SW_PUSH_6mm
U1: 80386; Intel386DX
U2, U3: IS61C25616; TSOP-II-44_10.16x18.41mm_P0.8mm
U4: 74AHC1G04; SOIC-6
U5: GAL22V10; DIP-24_W7.62mm_Socket
U6, U7: SST39SF010; PLCC-32_THT-Socket
U8: EPM240T100; LQFP-100_14x14mm_P0.5mm
U9, U18: AMS1117-3.3; SOT-223-3_TabPin2
U10: CF_CARD; CF-Card_3M_N7E50-E516xx-30_fixed
U11: SN74ALVC164245DGG; TSSOP-48_6.1x12.5mm_P0.5mm
U12, U13: SN74LVC8T245; TSSOP-24_4.4x7.8mm_P0.65mm
U14: SN74LV1T34DCK; SOT-23-5
U15: IS61WV102416FBLL; TSOP-I-48_18.4x12mm_P0.5mm
U16: ICS501; SOIC-8_3.9x4.9mm_P1.27mm
U17: MCP1319MT-29LE-OT; SOT-23-5
X1: CXO_DIP8; Oscillator_DIP-8

Connections:
3V3_A2: U8.97 (IO2_97), U13.5 (A3)
3V3_A3: U8.98 (IO2_98), U13.6 (A4)
3V3_A4: U8.99 (IO2_99), U13.7 (A5)
3V3_D0: U8.2 (IO1_2), U11.47 (1A0)
3V3_D1: U8.3 (IO1_3), U11.46 (1A1)
3V3_D2: U8.4 (IO1_4), U11.44 (1A2)
3V3_D3: U8.5 (IO1_5), U11.43 (1A3)
3V3_D4: U8.6 (IO1_6), U11.41 (1A4)
3V3_D5: U8.7 (IO1_7), U11.40 (1A5)
3V3_D6: U8.8 (IO1_8), U11.38 (1A6)
3V3_D7: U8.15 (IO1_15), U11.37 (1A7)
3V3_D8: U8.16 (IO1_16), U11.36 (2A0)
3V3_D9: U8.17 (IO1_17), U11.35 (2A1)
3V3_D10: U8.18 (IO1_18), U11.33 (2A2)
3V3_D11: U8.19 (IO1_19), U11.32 (2A3)
3V3_D12: U8.20 (IO1_20), U11.30 (2A4)
3V3_D13: U8.21 (IO1_21), U11.29 (2A5)
3V3_D14: U8.26 (IO1_26), U11.27 (2A6)
3V3_D15: U8.27 (IO1_27), U11.26 (2A7)
3V3_D16: U8.28 (IO1_28), U12.3 (A1)
3V3_D17: U8.29 (IO1_29), U12.4 (A2)
3V3_D18: U8.30 (IO1_30), U12.5 (A3)
3V3_D19: U8.33 (IO1_33), U12.6 (A4)
3V3_D20: U8.34 (IO1_34), U12.7 (A5)
3V3_D21: U8.35 (IO1_35), U12.8 (A6)
3V3_D22: U8.36 (IO1_36), U12.9 (A7)
3V3_D23: U8.37 (IO1_37), U12.10 (A8)
3V3_INT: U8.100 (IO2_100), U14.2 (A)
3V3_M/~IO: U8.49 (IO1_49), U13.3 (A1)
3V3_W/~R: U8.50 (IO1_50), U13.4 (A2)
+3V3: C2.1, C4.2, C5.2, C6.2, C8.2, C11.2, C12.2, C13.1, D4.2 (A), J1.4, J2.1, J3.1, R4.2, R5.2, R6.2, R7.2, R8.2, R14.2, R17.1, U8.9 (VCCIO1), U8.13 (VCCINT), U8.31 (VCCIO1), U8.45 (VCCIO1), U8.59 (VCCIO2), U8.63 (VCCINT), U8.80 (VCCIO2), U8.94 (VCCIO2), U9.2 (VO), U11.31 (V_{CC(A)}), U11.42 (V_{CC(A)}), U12.1 (Vcca), U13.1 (Vcca), U15.12 (Vdd), U15.36 (Vdd), U16.2 (Vdd), U16.7 (OE)
+5V: C1.1, C3.1, C7.1, C9.2, C10.2, C14.1, C15.2, C16.2, C17.2, C18.2, C19.2, C20.2, C21.1, C22.2, C23.2, C24.2, D1.2 (A), D2.2 (A), J4.1, J5.4, J7.2, R9.1, R10.1, U1.A1 (Vcc), U1.A5 (Vcc), U1.A7 (Vcc), U1.A8 (~ERROR), U1.A10 (Vcc), U1.A14 (Vcc), U1.B9 (~BUSY), U1.C5 (Vcc), U1.C12 (Vcc), U1.D12 (Vcc), U1.D13 (~NA), U1.G2 (Vcc), U1.G3 (Vcc), U1.G12 (Vcc), U1.G14 (Vcc), U1.L12 (Vcc), U1.M3 (Vcc), U1.M7 (Vcc), U1.M13 (Vcc), U1.N4 (Vcc), U1.N7 (Vcc), U1.P2 (Vcc), U1.P8 (Vcc), U2.11 (VDD), U2.33 (VDD), U3.11 (VDD), U3.33 (VDD), U4.5 (VCC), U5.24 (VCC), U6.31 (PGM), U6.32 (VCC), U7.31 (PGM), U7.32 (VCC), U9.3 (VI), U10.13 (Vcc), U10.36 (~WE), U10.38 (Vcc), U10.44 (~REG), U11.7 (V_{CC(B)}), U11.18 (V_{CC(B)}), U12.23 (Vccb), U12.24 (Vccb), U13.23 (Vccb), U13.24 (Vccb), U14.5 (VCC), U17.5 (VDD), X1.8 (Vcc)
A1: U5.19 (I/O), U6.12 (A0), U7.12 (A0)
A2: U1.C4 (A2), U2.44 (A0), U3.44 (A0), U6.11 (A1), U7.11 (A1), U13.19 (B3)
A3: U1.A3, U2.43 (A1), U3.43 (A1), U6.10 (A2), U7.10 (A2), U13.18 (B4)
A4: U1.B3 (A4), U2.42 (A2), U3.42 (A2), U6.9 (A3), U7.9 (A3), U10.20 (A0), U13.17 (B5)
A5: U1.B2 (A5), U2.27 (A3), U3.27 (A3), U6.8 (A4), U7.8 (A4), U10.19 (A1)
A6: U1.C3 (A6), U2.26 (A4), U3.26 (A4), U6.7 (A5), U7.7 (A5), U10.18 (A2)
A7: U1.C2 (A7), U2.25 (A5), U3.25 (A5), U6.6 (A6), U7.6 (A6)
A8: U1.C1 (A8), U2.24 (A6), U3.24 (A6), U6.5 (A7), U7.5 (A7)
A9: U1.D3 (A9), U2.21 (A7), U3.21 (A7), U6.27 (A8), U7.27 (A8)
A10: U1.D2 (A10), U2.20 (A8), U3.20 (A8), U5.10 (I), U6.26 (A9), U7.26 (A9)
A11: U1.D1 (A11), U2.19 (A9), U3.19 (A9), U6.23 (A10), U7.23 (A10)
A12: U1.E3 (A12), U2.18 (A10), U3.18 (A10), U6.25 (A11), U7.25 (A11)
A13: U1.E2 (A13), U2.5 (A11), U3.5 (A11), U5.9 (I), U6.4 (A12), U7.4 (A12)
A14: U1.E1 (A14), U2.4 (A12), U3.4 (A12), U6.28 (A13), U7.28 (A13)
A15: U1.F1 (A15), U2.3 (A13), U3.3 (A13), U6.29 (A14), U7.29 (A14)
A16: U1.G1 (A16), U2.2 (A14), U3.2 (A14), U6.3 (A15), U7.3 (A15)
A17: U1.H1 (A17), U2.1 (A15), U3.1 (A15), U6.2 (A16), U7.2 (A16)
A18: U1.H2 (A18), U2.22 (A16), U3.22 (A16)
A19: U1.H3 (A19), U2.23 (A17), U3.23 (A17)
A20: U1.J1 (A20)
A21: U1.K1 (A21)
A22: U1.K2 (A22)
A23: U1.L1 (A23)
A24: U1.L2 (A24)
A25: U1.K3 (A25)
A26: U1.M1 (A26)
A27: U1.N1 (A27)
A28: U1.L3 (A28)
A29: U1.M2 (A29)
A30: U1.P1 (A30)
A31: U1.N2 (A31), U4.2, U5.8 (I)
BDIR: R18.2, U8.14 (IO1_14/GCLK1), U11.1 (1DIR), U11.24 (2DIR), U12.2 (DIR)
CLK: U1.F12 (CLK2), U5.1 (I), U16.1 (X1/ICLK), X1.5 (OUT)
D0: U1.H12 (D0), U2.7 (IO0), U6.13 (D0), U10.21 (D0), U11.2 (1B0)
D1: U1.H13 (D1), U2.8 (IO1), U6.14 (D1), U10.22 (D1), U11.3 (1B1)
D2: U1.H14 (D2), U2.9 (IO2), U6.15 (D2), U10.23 (D2), U11.5 (1B2)
D3: U1.J14 (D3), U2.10 (IO3), U6.17 (D3), U10.2 (D3), U11.6 (1B3)
D4: U1.K14 (D4), U2.13 (IO4), U6.18 (D4), U10.3 (D4), U11.8 (1B4)
D5: U1.K13 (D5), U2.14 (IO5), U6.19 (D5), U10.4 (D5), U11.9 (1B5)
D6: U1.L14 (D6), U2.15 (IO6), U6.20 (D6), U10.5 (D6), U11.11 (1B6)
D7: U1.K12 (D7), U2.16 (IO7), U6.21 (D7), U10.6 (D7), U11.12 (1B7)
D8: U1.L13 (D8), U2.29 (IO8), U7.13 (D0), U10.47 (D8), U11.13 (2B0)
D9: U1.N14 (D9), U2.30 (IO9), U7.14 (D1), U10.48 (D9), U11.14 (2B1)
D10: U1.M12 (D10), U2.31 (IO10), U7.15 (D2), U10.49 (D10), U11.16 (2B2)
D11: U1.N13 (D11), U2.32 (IO11), U7.17 (D3), U10.27 (D11), U11.17 (2B3)
D12: U1.N12 (D12), U2.35 (IO12), U7.18 (D4), U10.28 (D12), U11.19 (2B4)
D13: U1.P13 (D13), U2.36 (IO13), U7.19 (D5), U10.29 (D13), U11.20 (2B5)
D14: U1.P12 (D14), U2.37 (IO14), U7.20 (D6), U10.30 (D14), U11.22 (2B6)
D15: U1.M11 (D15), U2.38 (IO15), U7.21 (D7), U10.31 (D15), U11.23 (2B7)
D16: U1.N11 (D16), U3.7 (IO0), U12.21 (B1)
D17: U1.N10 (D17), U3.8 (IO1), U12.20 (B2)
D18: U1.P11 (D18), U3.9 (IO2), U12.19 (B3)
D19: U1.P10 (D19), U3.10 (IO3), U12.18 (B4)
D20: U1.M9 (D20), U3.13 (IO4), U12.17 (B5)
D21: U1.N9 (D21), U3.14 (IO5), U12.16 (B6)
D22: U1.P9 (D22), U3.15 (IO6), U12.15 (B7)
D23: U1.N8 (D23), U3.16 (IO7), U12.14 (B8)
D24: U1.P7 (D24), U3.29 (IO8)
D25: U1.N6 (D25), U3.30 (IO9)
D26: U1.P5 (D26), U3.31 (IO10)
D27: U1.N5 (D27), U3.32 (IO11)
D28: U1.M6 (D28), U3.35 (IO12)
D29: U1.P4 (D29), U3.36 (IO13)
D30: U1.P3 (D30), U3.37 (IO14)
D31: U1.M5 (D31), U3.38 (IO15)
DISP_D/~C: J6.7, U8.96 (IO2_96), U15.18 (~WE)
D/~C: R2.2, U1.A11 (D/~C)
GND: C1.2, C2.2, C3.2, C4.1, C5.1, C6.1, C7.2, C8.1, C9.1, C10.1, C11.1, C12.1, C13.2, C14.2, C15.1, C16.1, C17.1, C18.1, C19.1, C20.1, C21.2, C22.1, C23.1, C24.1, C25.2, C26.2, J1.2, J1.10, J2.3, J3.3, J4.5, J4.6, J5.3, J6.1, J7.1, J8.1, R3.2, R11.1, R13.2, R18.1, R19.2, SW1.1, U1.A2 (GND), U1.A6 (GND), U1.A9 (GND), U1.B1 (GND), U1.B5 (GND), U1.B7 (INTR), U1.B11 (GND), U1.B14 (GND), U1.C8 (PEREQ), U1.C11 (GND), U1.D14 (HOLD), U1.F2 (GND), U1.F3 (GND), U1.F14 (GND), U1.J2 (GND), U1.J3 (GND), U1.J12 (GND), U1.J13 (GND), U1.M4 (GND), U1.M8 (GND), U1.M10 (GND), U1.N3 (GND), U1.P6 (GND), U1.P14 (GND), U2.12 (GND), U2.34 (GND), U3.12 (GND), U3.34 (GND), U4.3 (GND), U5.12 (GND), U6.16 (GND), U7.16 (GND), U8.10 (GNDIO), U8.11 (GNDINT), U8.32 (GNDIO), U8.46 (GNDIO), U8.60 (GNDIO), U8.65 (GNDINT), U8.79 (GNDIO), U8.93 (GNDIO), U9.1 (GND), U10.1 (GND), U10.8 (A10), U10.9 (~ATASEL), U10.10 (A9), U10.11 (A8), U10.12 (A7), U10.14 (A6), U10.15 (A5), U10.16 (A4), U10.17 (A3), U10.25 (~CD2), U10.26 (~CD1), U10.39 (~CSEL), U10.46 (~PDIAG), U10.50 (GND), U11.4 (GND), U11.10 (GND), U11.15 (GND), U11.21 (GND), U11.25 (2~OE), U11.28 (GND), U11.34 (GND), U11.39 (GND), U11.45 (GND), U11.48 (1~OE), U12.11 (GND), U12.12 (GND), U12.13 (GND), U12.22 (~OE), U13.2 (DIR), U13.11 (GND), U13.12 (GND), U13.13 (GND), U13.22 (~OE), U14.3 (GND), U15.13 (Vss), U15.37 (Vss), U16.3 (GND), U17.2 (VSS), U18.1 (GND), X1.4 (GND)
INT: U1.B8 (NMI), U14.4 (Y)
M/~IO: U1.A12 (M/~IO), U5.13 (I)
NES_CLK: J4.2, U8.42 (IO1_42)
NES_DATA: R11.2, R12.1, U8.47 (IO1_47)
NES_LATCH: D6.2 (A), J4.3, U8.43 (IO1_43/DEV_OE)
unnamed: D1.1 (K), R1.1
unnamed: D2.1 (K), R2.1
unnamed: D3.2 (A), R10.2
unnamed: D3.1 (K), U10.45 (~DASP)
unnamed: D4.1 (K), R13.1
unnamed: D5.1 (K), D6.1 (K), R19.1
unnamed: J1.1, R3.1, U8.24 (TCK)
unnamed: J1.3, R4.1, U8.25 (TDO)
unnamed: J1.5, R5.1, U8.22 (TMS)
unnamed: J1.9, R6.1, U8.23 (TDI)
unnamed: J2.2, U16.6 (S0)
unnamed: J3.2, U16.4 (S1)
unnamed: J4.4, R12.2
unnamed: C26.1, J6.3, R15.1, R16.2, U18.2 (VO)
unnamed: J6.20, R15.2
unnamed: J6.37, R16.1
unnamed: C25.1, J8.2, U18.3 (VI)
unnamed: R1.2, U1.C10 (~LOCK)
unnamed: U5.18 (I/O), U13.21 (B1)
unnamed: U8.12 (IO1_12/GCLK0), U16.5 (CLK)
unnamed: R9.2, SW1.2, U17.4 (~MR)
RESET: U1.C9 (RESET), U5.11 (I), U17.3 (RST)
URX: J5.2, R14.1, U8.39 (IO1_39)
UTX: J5.1, U8.38 (IO1_38)
VRAM_A0: U8.71 (IO2_71), U15.5 (A0)
VRAM_A1: U8.72 (IO2_72), U15.4 (A1)
VRAM_A2: U8.73 (IO2_73), U15.3 (A2)
VRAM_A3: U8.74 (IO2_74), U15.2 (A3)
VRAM_A4: U8.75 (IO2_75), U15.1 (A4)
VRAM_A5: U8.76 (IO2_76), U15.48 (A5)
VRAM_A6: U8.77 (IO2_77), U15.47 (A6)
VRAM_A7: U8.78 (IO2_78), U15.46 (A7)
VRAM_A8: U8.81 (IO2_81), U15.45 (A8)
VRAM_A9: U8.82 (IO2_82), U15.30 (A9)
VRAM_A10: U8.83 (IO2_83), U15.29 (A10)
VRAM_A11: U8.84 (IO2_84), U15.28 (A11)
VRAM_A12: U8.85 (IO2_85), U15.27 (A12)
VRAM_A13: U8.86 (IO2_86), U15.26 (A13)
VRAM_A14: U8.87 (IO2_87), U15.25 (A14)
VRAM_A15: U8.88 (IO2_88), U15.24 (A15)
VRAM_A16: U8.89 (IO2_89), U15.23 (A16)
VRAM_A17: U8.90 (IO2_90), U15.22 (A17)
VRAM_A18: U8.91 (IO2_91), U15.21 (A18)
VRAM_A19: U8.92 (IO2_92), U15.20 (A19)
VRAM_D0: J6.2, U8.1 (IO2_1), U15.8 (IO0)
VRAM_D1: D5.2 (A), J6.4, U8.52 (IO2_52), U15.9 (IO1)
VRAM_D2: J6.6, U8.53 (IO2_53), U15.10 (IO2)
VRAM_D3: J6.8, U8.54 (IO2_54), U15.11 (IO3)
VRAM_D4: J6.10, U8.55 (IO2_55), U15.14 (IO4)
VRAM_D5: J6.12, U8.56 (IO2_56), U15.15 (IO5)
VRAM_D6: J6.14, U8.57 (IO2_57), U15.16 (IO6)
VRAM_D7: J6.16, U8.58 (IO2_58), U15.17 (IO7)
VRAM_D8: J6.13, U8.61 (IO2_61), U15.32 (IO8)
VRAM_D9: J6.15, U8.62 (IO2_62/GCLK2), U15.33 (IO9)
VRAM_D10: J6.17, U8.64 (IO2_64/GCLK3), U15.34 (IO10)
VRAM_D11: J6.19, U8.66 (IO2_66), U15.35 (IO11)
VRAM_D12: J6.21, U8.67 (IO2_67), U15.38 (IO12)
VRAM_D13: J6.23, U8.68 (IO2_68), U15.39 (IO13)
VRAM_D14: J6.25, U8.69 (IO2_69), U15.40 (IO14)
VRAM_D15: J6.27, U8.70 (IO2_70), U15.41 (IO15)
W/~R: U1.B10 (W/~R), U2.41 (~OE), U3.41 (~OE), U5.6 (I), U6.24 (OE), U7.24 (OE), U10.34 (~IORD), U13.20 (B2)
~3V3_ADS: U8.48 (IO1_48), U13.8 (A6)
~A31: U1.C14 (~BS16), U4.4
~ADS: U1.E14 (~ADS), U5.7 (I), U13.14 (B8), U13.15 (B7), U13.16 (B6)
~ATA_CS0: U5.17 (I/O), U10.7 (~CS0)
~ATA_CS1: U5.16 (I/O), U10.32 (~CS1)
~BE0: U1.E12 (~BE0), U2.39 (~LB), U5.2 (I)
~BE1: U1.C13 (~BE1), U2.40 (~UB), U5.3 (I)
~BE2: U1.B13 (~BE2), U3.39 (~LB), U5.4 (I)
~BE3: U1.A13 (~BE3), U3.40 (~UB), U5.5 (I)
~DISP_CS: J6.29, R7.1, U8.44 (IO1_44/DEV_CLRn)
~DISP_RD: J6.11, R17.2
~DISP_WR: J6.9, U8.95 (IO2_95), U15.44 (~OE)
~RAMCE: U2.6 (~CE), U3.6 (~CE), U5.22 (I/O)
~READY: U1.G13 (~READY), U5.14 (I/O)
~RESET: J6.33, U10.41 (~RESET), U17.1 (~RST)
~ROMCS: U5.20 (I/O), U6.22 (CE), U7.22 (CE)
~VRAM_CS: R8.1, U8.51 (IO1_51), U15.7 (~CS)
~VRAM_LB: U8.40 (IO1_40), U15.42 (~LB)
~VRAM_UB: U8.41 (IO1_41), U15.43 (~UB)
~WE: U2.17 (~WE), U3.17 (~WE), U5.23 (I/O), U10.35 (~IOWR)

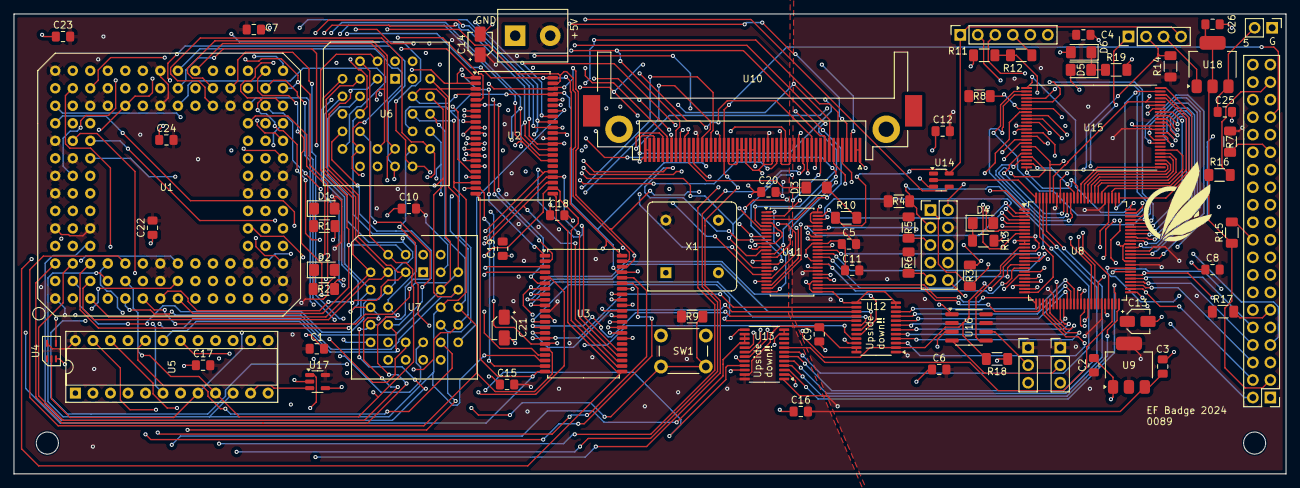
[picture p10: board EF-Badge-2024.kicad_pcb from above]

Board: 4 copper layers, 184.4 x 66.7 mm, 81 parts (0 on the bottom side), 175 nets.
