89Mods/con-badges/EF-Badge-2025/VerilogBench/VLIW/icache.v

module icache(
	input [27:0] curr_PC,
	output [127:0] cache_entry,
	output cache_hit,
	
	input [127:0] new_entry,
	input entry_valid,
	
	input invalidate,
	input clk,
	input rst
);

reg [127:0] cache_packs [31:0];
reg [27:0] cache_addrs [31:0];

reg [5:0] hit_cache_entry;
always @(*) begin
	if(cache_addrs[0] == curr_PC) hit_cache_entry = 0;
	else if(cache_addrs[1] == curr_PC) hit_cache_entry = 1;
	else if(cache_addrs[2] == curr_PC) hit_cache_entry = 2;
	else if(cache_addrs[3] == curr_PC) hit_cache_entry = 3;
	else if(cache_addrs[4] == curr_PC) hit_cache_entry = 4;
	else if(cache_addrs[5] == curr_PC) hit_cache_entry = 5;
	else if(cache_addrs[6] == curr_PC) hit_cache_entry = 6;
	else if(cache_addrs[7] == curr_PC) hit_cache_entry = 7;
	else if(cache_addrs[8] == curr_PC) hit_cache_entry = 8;
	else if(cache_addrs[9] == curr_PC) hit_cache_entry = 9;
	else if(cache_addrs[10] == curr_PC) hit_cache_entry = 10;
	else if(cache_addrs[11] == curr_PC) hit_cache_entry = 11;
	else if(cache_addrs[12] == curr_PC) hit_cache_entry = 12;
	else if(cache_addrs[13] == curr_PC) hit_cache_entry = 13;
	else if(cache_addrs[14] == curr_PC) hit_cache_entry = 14;
	else if(cache_addrs[15] == curr_PC) hit_cache_entry = 15;
	else if(cache_addrs[16] == curr_PC) hit_cache_entry = 16;
	else if(cache_addrs[17] == curr_PC) hit_cache_entry = 17;
	else if(cache_addrs[18] == curr_PC) hit_cache_entry = 18;
	else if(cache_addrs[19] == curr_PC) hit_cache_entry = 19;
	else if(cache_addrs[20] == curr_PC) hit_cache_entry = 20;
	else if(cache_addrs[21] == curr_PC) hit_cache_entry = 21;
	else if(cache_addrs[22] == curr_PC) hit_cache_entry = 22;
	else if(cache_addrs[23] == curr_PC) hit_cache_entry = 23;
	else if(cache_addrs[24] == curr_PC) hit_cache_entry = 24;
	else if(cache_addrs[25] == curr_PC) hit_cache_entry = 25;
	else if(cache_addrs[26] == curr_PC) hit_cache_entry = 26;
	else if(cache_addrs[27] == curr_PC) hit_cache_entry = 27;
	else if(cache_addrs[28] == curr_PC) hit_cache_entry = 28;
	else if(cache_addrs[29] == curr_PC) hit_cache_entry = 29;
	else if(cache_addrs[30] == curr_PC) hit_cache_entry = 30;
	else if(cache_addrs[31] == curr_PC) hit_cache_entry = 31;
	else hit_cache_entry = 32;
end
assign cache_hit = !hit_cache_entry[5];
assign cache_entry = cache_packs[hit_cache_entry];

reg [15:0] rng;

wire [15:0] rng_1 = rng ^ {7'h00, rng[15:7]};
wire [15:0] rng_2 = rng_1 ^ {rng_1[6:0], 9'h000};
wire [15:0] rng_3 = rng_2 ^ {13'h0000, rng_2[15:14]};
wire [4:0] random_entry = {rng[13], rng[12], rng[10], rng[7], rng[3]};

always @(posedge clk) begin
	if(rst || invalidate) begin
		if(rst) rng <= 16'hABCD;
		cache_addrs[0] <= 28'hFFFFFFF; cache_addrs[1] <= 28'hFFFFFFF; cache_addrs[2] <= 28'hFFFFFFF; cache_addrs[3] <= 28'hFFFFFFF;
		cache_addrs[4] <= 28'hFFFFFFF; cache_addrs[5] <= 28'hFFFFFFF; cache_addrs[6] <= 28'hFFFFFFF; cache_addrs[7] <= 28'hFFFFFFF;
		cache_addrs[8] <= 28'hFFFFFFF; cache_addrs[9] <= 28'hFFFFFFF; cache_addrs[10] <= 28'hFFFFFFF; cache_addrs[11] <= 28'hFFFFFFF;
		cache_addrs[12] <= 28'hFFFFFFF; cache_addrs[13] <= 28'hFFFFFFF; cache_addrs[14] <= 28'hFFFFFFF; cache_addrs[15] <= 28'hFFFFFFF;
		cache_addrs[16] <= 28'hFFFFFFF; cache_addrs[17] <= 28'hFFFFFFF; cache_addrs[18] <= 28'hFFFFFFF; cache_addrs[19] <= 28'hFFFFFFF;
		cache_addrs[20] <= 28'hFFFFFFF; cache_addrs[21] <= 28'hFFFFFFF; cache_addrs[22] <= 28'hFFFFFFF; cache_addrs[23] <= 28'hFFFFFFF;
		cache_addrs[24] <= 28'hFFFFFFF; cache_addrs[25] <= 28'hFFFFFFF; cache_addrs[26] <= 28'hFFFFFFF; cache_addrs[27] <= 28'hFFFFFFF;
		cache_addrs[28] <= 28'hFFFFFFF; cache_addrs[29] <= 28'hFFFFFFF; cache_addrs[30] <= 28'hFFFFFFF; cache_addrs[31] <= 28'hFFFFFFF;
	end else if(entry_valid) begin
		cache_packs[random_entry] <= new_entry;
		cache_addrs[random_entry] <= curr_PC;
	end else begin
		rng <= rng_3;
	end
end

`ifdef SIM
wire [127:0] p0 = cache_packs[0];
wire [127:0] p1 = cache_packs[1];
wire [127:0] p2 = cache_packs[2];
wire [127:0] p3 = cache_packs[3];
wire [127:0] p4 = cache_packs[4];
wire [127:0] p5 = cache_packs[5];
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
wire [27:0] a24 = cache_addrs[24];
wire [27:0] a25 = cache_addrs[25];
wire [27:0] a26 = cache_addrs[26];
wire [27:0] a27 = cache_addrs[27];
wire [27:0] a28 = cache_addrs[28];
wire [27:0] a29 = cache_addrs[29];
wire [27:0] a30 = cache_addrs[30];
wire [27:0] a31 = cache_addrs[31];
`endif

endmodule
