89Mods/con-badges/EF-Badge-2025/SW/Boot/bitmap.asm

    align 4
bitmap:
    db 0x00,0x00,0x00,0x00,0x00,0x00,0x00,0x00,0x00,0x00
    db 0x00,0x00,0x00,0x00,0x00,0x00,0x00,0x00,0x00,0x00
    db 0x00,0x00,0x00,0x00,0x00,0x00,0x00,0x00,0x00,0x00
    db 0x00,0x00,0x00,0x00,0x00,0x00,0x00,0x00,0x00,0x00
    db 0x00,0x00,0x00,0x00,0x00,0x00,0x00,0x00,0x00,0x00
    db 0x00,0x00,0x00,0x00,0x00,0x00,0x00,0x00,0x00,0x00
    db 0x00,0x00,0x00,0x00,0x00,0x00,0x00,0x00,0x00,0x00
    db 0x00,0x00,0x00,0x00,0x00,0x00,0x00,0x00,0x00,0x00
    db 0x00,0x00,0x00,0x00,0x00,0x00,0x00,0x00,0x00,0x00
    db 0x00,0x00,0x00,0x00,0x00,0x00,0x00,0x00,0x00,0x00
    db 0x00,0x00,0x00,0x00,0x00,0x00,0x00,0x00,0x00,0x00
    db 0x00,0x00,0x00,0x00,0x00,0x00,0x00,0x00,0x00,0x00
    db 0x00,0x00,0x00,0x00,0x00,0x00,0x00,0x00,0x00,0x00
    db 0x00,0x00,0x00,0x00,0x00,0x00,0x00,0x00,0x00,0x00
    db 0x00,0x00,0x00,0x00,0x00,0x00,0x00,0x00,0x00,0x00
    db 0x00,0x00,0x00,0x00,0x00,0x00,0x00,0x00,0x00,0x00
    db 0x00,0x00,0x00,0x00,0x00,0x00,0x00,0x00,0x00,0x00
    db 0x00,0x00,0x00,0x00,0x00,0x00,0x00,0x00,0x00,0x00
    db 0x00,0x00,0x00,0x00,0x00,0x00,0x00,0x00,0x00,0x00
    db 0x00,0x00,0x00,0x00,0x00,0x00,0x00,0x00,0x00,0x00
    db 0x00,0x00,0x00,0x00,0x00,0x00,0x00,0x00,0x00,0x00
    db 0x00,0x00,0x00,0x00,0x00,0x00,0x00,0x00,0x00,0x00
    db 0x00,0x00,0x00,0x00,0x00,0x00,0x00,0x00,0x00,0x00
    db 0x00,0x00,0x00,0x00,0x00,0x00,0x00,0x00,0x00,0x00
    db 0x00,0x00,0x00,0x00,0x00,0x00,0x00,0x00,0x00,0x00
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
    db 0x00,0x00,0x00,0x00,0x00,0x00,0x00,0x00,0x00,0x00
    db 0xff,0xff,0xff,0xff,0xff,0xff,0xff,0xff,0xff,0xff
    db 0x00,0x00,0x00,0x0f,0xff,0xff,0xff,0xff,0xff,0x00
    db 0x00,0x00,0x00,0x00,0x00,0x00,0xff,0xff,0xf8,0x00
    db 0x00,0x00,0x00,0x7f,0xff,0xff,0xff,0xff,0xff,0xff
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
