89Mods/con-badges/EF-Badge-2025/SW/Boot/pgmdata.h

const uint32_t pgm[] = {
	0xfe03e8a2,0x0fa28801,0x805fffc0,0x8000af5e,0x6cedd805,0x0001e001,0x07800000,0x80000000,0x00000078,0x0001e000,0x00600000,0x00000fc0,0x00000078,0x0001e000,0x00600000,0x00000fc0,
	0x00000078,0x0001e000,0x00600000,0x00000fc0,0x76edd839,0x9720e400,0x078001cb,0x00000000,0xfe03f0a2,0x00628bff,0x0a200ed4,0x3fe0003f,0x0203d0a2,0x0f428804,0x07820000,0x00000000,
	0x58f8184c,0x4080e400,0x84c00020,0x00080f9d,0x040020a2,0xe0813002,0x07800183,0x40000000,0x00000078,0x00828800,0x04c012c4,0x80038f82,0x400280a2,0x0a0289f1,0x07800008,0x00000000,
	0x80ede00a,0xc7801800,0x078002b3,0x40000000,0x80ede00a,0x00428800,0x00600004,0x40148f1e,0x80ede00a,0xc7801800,0x0780295b,0x40000000,0x00000078,0x00c28800,0x04c00014,0x80068f83,
	0xfc0008a2,0x08428aed,0x0a280040,0x00002021,0x000230a2,0x08c28800,0x07801808,0x00000000,0x00081804,0x00828800,0x07800070,0x00000000,0x04081002,0x30624800,0x07800180,0x00000000,
	0x840228a2,0x08a289e4,0x863fffc8,0x000760c0,0xfd0029a2,0x0001e3ff,0x07800000,0x00000000,0x060c1801,0x60a13000,0x07800000,0x00000000,0x10183002,0x40820800,0x02500010,0x3fffaec2,
	0x04040882,0xb0209400,0x078fffd3,0x00000000,0x68f9d84c,0x0001e000,0x07800000,0x00000000,0xb00008a2,0xa020b000,0x07800e03,0x40000000,0x90e8082c,0x0001e003,0x07800000,0x00000000,
	0x800008a2,0xa020b000,0x07800e03,0x40000000,0x80ede00a,0xc7801800,0x07800363,0x40000000,0x00000078,0x0001e000,0x07800000,0x00000000,0x80ede00a,0xc7801800,0x07800a6b,0x40000000,
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
	0x04408002,0x0001e000,0x00500000,0x3fffcec0,0x00800006,0x0001e000,0x07800000,0x00000000,0xe80280a2,0x0a0289f1,0x07800008,0x00000000,0x80ede00a,0xc7801800,0x078ffe1b,0x40000000,
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
	'C','h','i','r','p','!'
};
const uint32_t pgm_len = 20199;
