89Mods/con-badges/EF-Badge-2025/SW/BenchMemTest/pgmdata.h

const uint32_t pgm[] = {
	0xfe03e8a2,0x0fa28801,0x805fffc0,0x8000af5e,0x00000078,0x0001e000,0x80500000,0x00030edd,0x00000078,0x0001e000,0x00600000,0x00000fc0,0x00000078,0x0001e000,0x00600000,0x00000fc0,
	0x00000078,0x0001e000,0x00600000,0x00000fc0,0x76edd839,0x0001e000,0x07800000,0x00000000,0xfe03f0a2,0x00628bff,0x0a200ed4,0x3fe0003f,0x0203d0a2,0x0f428804,0x07820000,0x00000000,
	0x58f8184c,0x4080e400,0x84c00020,0x00080f9d,0x040020a2,0xe0813000,0x07800183,0x40000000,0x020250a2,0x09428806,0x07800000,0x00000000,0xc20258a2,0x09628bfc,0x07830300,0x00000000,
	0x0828584c,0x0001e000,0x07800000,0x00000000,0xfe0258a2,0x09628a87,0x07800880,0x00000000,0x0828584c,0xb160e400,0x84400058,0xc0008285,0xc40008a2,0xa020b002,0x07800853,0x40000000,
	0x200208a2,0x08228802,0x84c00008,0x80220e80,0x18e9d84c,0x00228802,0x82c00280,0x80204e80,0xfd0008a2,0xe02133ff,0x84c00043,0xc0018f80,0x20f9d84c,0xe7613000,0x84c000a3,0xc0000f9d,
	0x08f9d84c,0x00228800,0x84c00024,0x80070f80,0x00e80824,0x00228802,0x82c00380,0xc0204e80,0x600008a2,0xe0213000,0x078001e3,0xc0000000,0x00000078,0x0001e000,0x07800000,0x00000000,
	0x00000078,0x0001e000,0x00500000,0x3fffe285,0x20f5e882,0xd0213000,0x04c00023,0xc0010f5e,0x04e80824,0x1020a802,0x80500100,0xc0004ec0,0x80ede00a,0xc7801800,0x07800033,0x40000000,
	0x04e80824,0x1020a802,0x80500020,0xc0004ec0,0x80ede00a,0xc7801800,0x07800033,0x40000000,0x04e80824,0x1020a802,0x82500120,0xffff8ec0,0x08f40844,0xd7811000,0x80200043,0xc0020f5e,
	0x040008a2,0xe0213000,0x006001e3,0xc0000fc0,0x60f80844,0x1020e800,0x84c00400,0xc0060f80,0xe00008a2,0xa020b000,0x00600813,0x40000f00,0x60f80844,0x1020e800,0x84c00400,0xc0060f80,
	0x00e80824,0xc0001802,0x07800003,0x00000000,
	'C','h','i','r','p','!'
};
const uint32_t pgm_len = 154;
