89Mods/con-badges/(commit log)

2024-09-29 Initial commit, EF 2024 badge
    [EF-Badge-2024.kicad_pcb, EF-Badge-2024.kicad_sch, badge-rom-programmer.kicad_pcb, badge-rom-programmer.kicad_sch]
2025-09-15 2025 Badge
    [FPGA.kicad_sch, HW.kicad_pcb, HW.kicad_sch, LEDS.kicad_sch, PSU.kicad_sch, RAM.kicad_sch]
